optimiseddesign/optimised_kicad-libraries/README.md

# optimised_kicad-libraries
Created by Kevin Bibby / Optimised Product Design Ltd, and available for public use (copyright reserved).
KiCAD v10 component library with common symbols, footprints, 3d models, datasheets and other content for our PCB designs.
Note: some parts are customised for our businesses use case, and there may be undiscovered issues, so use is at your own risk.
Intended to be placed as a sub-folder (local libaries) within a KiCAD design folder, using the Git submodule feature.
