optimiseddesign/optimised_kicad-libraries/models3d/Bluegiga WT12.stp

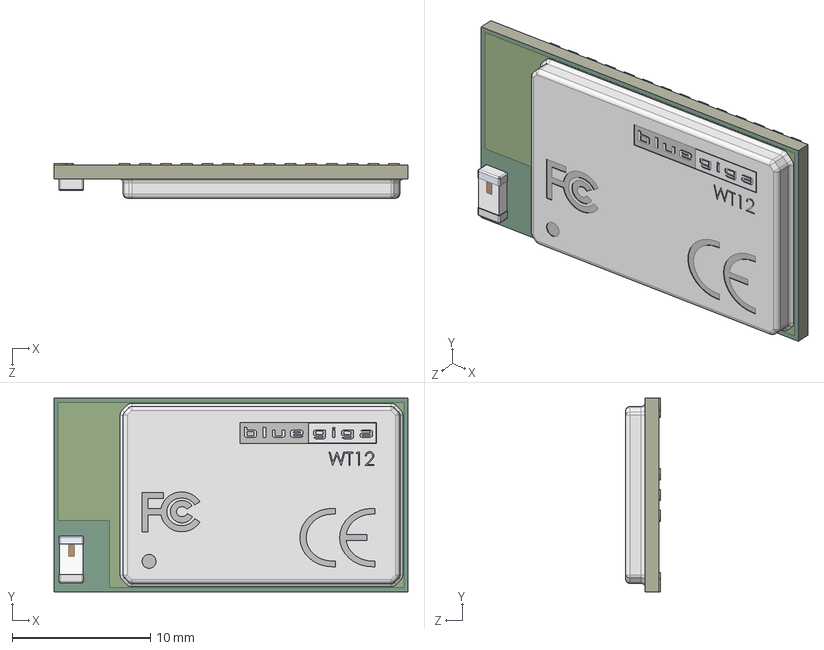
[picture p1: CAD file, 2019-12-03]
models3d/Bluegiga WT12.stp
25.6 x 14.0 x 2.50 mm
