optimiseddesign/optimised_kicad-libraries/documentation/new user setup.txt

Very rough intial notes to form basis for proper new user setup document/scripts.
Compiled from steps used 13/03/2020 when I got my replacement laptop.
-------------------------------------------------------------------------

Git 'Clone' the official library repos to C:\freelance\git\;
https://github.com/KiCad/kicad-symbols.git
https://github.com/KiCad/kicad-footprints.git
https://github.com/KiCad/kicad-packages3D.git
https://github.com/KiCad/kicad-templates.git

Git 'Reset' each one of these repos to the Tag which corresponds to the version of KiCAD installed (e.g. 5.1.4).

Install KiCAD.

Edit the following Windows environment variables (do this instead of KiCAD Preferences > Configure Paths, so they're persistent);
KICAD_SYMBOL_DIR		C:\freelance\git\kicad-symbols
KISYSMOD				C:\freelance\git\kicad-footprints
KISYS3DMOD				C:\freelance\git\kicad-packages3D
KICAD_TEMPLATE_DIR		C:\freelance\git\kicad-templates

Open KiCAD, and configure;
Preferences > Manage Symbol Libraries, then select global symbol table folder C:\freelance\git\kicad-symbols\sym-lib-table
Preferences > Manage Footprint Libraries, then select global footprint table folder C:\freelance\git\kicad-footprints\fp-lib-table

Added rough things after KiCAD v6, 2022-01-18;
-------------------------------------------------------------------------
Need to update all of above instructions for KiCAD v6, but most similar or fixed in my library

Install InteractiveHtmlBom v2.4.1 (or later with caution?) using plugin manager...
...copy config.ini from Git Repo optimised_kicad-libraries \environment\config.ini
...to C:\Users\<UserName>\Documents\KiCad\6.0\3rdparty\plugins\org_openscopeproject_InteractiveHtmlBom\ or similar

Clone KiBOM repo (Optimised fork) from https://github.com/optimiseddesign/KiBoM
In KiCAD Schematic Editor, Tools -> Generate BOM
Add a BOM generator with the Nickname and Commandline as below:
OptimisedPD_KiBOM_CSV
python "C:\freelance\git\KiBoM/KiBOM_CLI.py" -v "%I" "%O" -d "..\manufacturing"
plus, when outputting a BOM, temporarily copy \environment\bom.ini to the local KiCAD PCB folder
