optimiseddesign/optimised_kicad-libraries/(commit log)

2019-11-22 added gitattributes to convert line endings to LF for library files added blank schematic libraries
2019-11-22 added 3 footprint libraries to start off with renamed a couple of datasheet directories to match names for symbols
2019-11-22 added 3 models3d libaries to start off with to match footprint ones
2019-11-22 added fp-lib-table and sym-lib-table for symbols/footprints libraries so far
2019-11-22 added component led_smd_rgb_wurth_150141M173100 including footprint & step model & datasheet mainly to test out, still need to resolve many many things
2019-11-25 modified led_smd_rgb_wurth_150141M173100 - added part info & fields modified Wurth 150141M173100 footprint - regenerated from PCB Expert 2019-07 and datasheet... ...NOTE: polarity mark is on Pin3 as 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
2019-11-25 added spaces to unused fields in led_smd_rgb_wurth_150141M173100 so they don't get ignored... ...and made text sizes consistent added template symbols for CONNECTORS and DIODE-RECTIFIERS libraries
2019-11-25 renamed diodes-rectifiers library
2019-11-25 added Lumberg 1502 01 as 'audio_jack_3mm5_3contact_vertical_lumberg_1502-01'... ...including STEP model, datasheet etc, missing footprint for now & tweaks to symbol
2019-11-26 changed symbol and pins to match datasheet for audio_jack_3mm5_3contact_vertical_lumberg_1502-01 added STEP model for usb jack, Molex 105133-0001 added footprint for audio_jack_3mm5_3contact_vertical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
2019-11-26 added Molex 92315-1225 STEP model temporarily for cable assembly to use on PT106b
2019-12-02 added source files for Keystone #54 battery holder for 18650 (temp before library part fully made)
    [keystone-PN54.stp]
2019-12-02 added first rough version of a KiCAD pcbnew script... ...delete GND nets but unfortunately also deletes connected vias, to solve in future
2019-12-03 added miscellaneous footprint library to library path renamed Keystone 54 datasheet renamed & moved Keystone 54 step model added simple keystone 54 footprint (to be checked over etc) added generic 18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
2019-12-03 fix for delete_gnd_nets KiCAD pcbnew script which was causing it not to load added 3D STEP model for Bluegiga WT12 module, not yet organised/setup properly
    [Bluegiga WT12.stp]
2019-12-05 added assembly and silkscreen pin1 polarity marks added footprint description field moved silkscreen REF outside of component outline and added assembly/fab layer REF
2019-12-05 added symbol TEMPLATE_miscellaneous added batteryholder_18650_keystone-54 based on Battery_Cell official KiCAD symbol... ...tailored to match existing footprint for 18650 keystone 54 based part ...ad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
2019-12-10 removed central cross on F.CrtYd layer which PCB Expert creator adds but which causes KiCAD DRCs
2019-12-10 corrected pin numbering error on audio_jack_3mm5_3contact_vertical_lumberg_1502-01 after testing sample part
2019-12-20 adding KiCAD Titleblock file to test (just has test text added)
2019-12-20 renamed to say for Schematic
2019-12-20 copied the schematic titleblock for use as PCB Titleblock edited PCBLayout Titleblock test text to be distinct for PCB
2019-12-21 added PCB ID (uses Comment C0), copyright date, KB Consulting, etc to titelblock design removed test text from titleblock changed back to just one titleblock after testing, could do separate but don'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
2019-12-27 added Texas Instruments DRV2605L VSSOP-10 version to KBconsulting KiCAD library... ...incuding datasheet, part numbers etc, and new symbol ...uses footprint from official KiCAD library changed TEMPLA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
2019-12-30 adding templates for all library component types, setting RefDes, paths, pin names/numbers etc
2019-12-30 added ST Microelectronics LD39200PUR 2A DFN-6 Adjustable LDO regulator... ...added datasheet, uses existing official KiCAD footprint
2020-01-03 added first rough text for use in KiCAD design checklist document
2020-01-05 added bom.ini for KiBOM generation, default but customised for my fields etc make sure to temp change getDescription(self) in KiBOM component.py... ...if parts use "Description" field name (or change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
2020-01-05 added some more info to do with BOM generation
2020-01-24 changes to checklist to describe BOM output process better, using customised KiBOM
2020-03-13 added first rough notes for new user setup of kicad libraries
2020-03-13 lengthened batteryholder_18650_keystone_54 by 1.0mm after testing on VRGOmini main PCB PT106A 2.0 2A... ...some large protected 18650 cells are 70.5mm long (most 67-70mm) ...was 65.5mm between spring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
2020-03-15 added 'batteryholder_18650_keystone_54' hatched keepout indication on Dwgs.User layer & Cmts.User description
2020-04-13 added basic generic SMD resistors and capacitors 0402, 0603, 0805, 1206... ...uses symbols (R_small & C_small) and footprints from official KiCAD library ...1% for resistors, power rating ascending a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
2020-04-13 added basic generic 2.54mm header TH 01x04 way vertical... ...footprint & symbol (Connector_Generic / Conn_01x04) from official KiCAD libraries ...symbol pins modified to be shorter (2.54mm instead o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
2020-04-14 added security_microchip_atecc608a_i2c_soic-8... ...symbol copied from official KiCAD library (Security / ATECC608A-SSHDA) ...adjusted to add Pins 1,2,3,7 as NC invisible pins, and spaced pin text mo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
2020-04-14 added rtc_i2c_nxp_pcf8523_soic-8... ...symbol copied from official KiCAD library (Timer_RTC / PCF8523T) ...adjusted pin locations slightly ...footprint from official KiCAD library ...datasheet from n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
2020-04-14 added Crystal_32kHz_SMD_IQD_CFPX-217_20ppm_7pF... ...for IQD CFPX-217 with 20ppm tolerance, 7pF load (aka LFXTAL009709 order code) ...symbol copied from official KiCAD library (Device / Crystal_Small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
2020-04-14 renamed recent new components for new naming convention; not all lower-case added description in library parts where missing to help finding parts moved 'I2C' part of name to earlier in string for RT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
2020-04-14 added Cell-Holder_CR1220_Horizontal_SMD_Harwin_S8411-45R... ...symbol copied from official KiCAD library (Device / Battery_Cell) ...footprint created from scratch based on datasheet ...STEP model & d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
2020-04-15 added M12_Female_5pin_Right-Angle_TE-Connectivity_T4145015051-001... ...symbol copied (& heavily modified) from official KiCAD library (Connector / XLR5) ...footprint created from scratch based on da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
2020-04-15 corrected some part numbers put in the wrong fields added BT refdes for battery (cell) holder which just had 'REF?'
2020-04-16 added SODIMM-200_Socket_0.6mm_DDR2_Horizontal_SMD_TE-Connectivity_1473005-4... ...symbol & footprint modified from SnapEDA one (linked from TE website) ...symbol was only 100pins?! added remaining on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
2020-04-16 added USB2-A_Single_Horizontal_TH_Amphenol-ICC_UE27AC54100... ...symbol copied from official KiCAD (Connector / USB_A) ...symbol mirrored in vertical, pins & outline adjusted, D+/D- bidirectional pin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
2020-04-16 added USB2-B_Single_Horizontal_TH_TE-Connectivity_292304-1... ...symbol copied from official KiCAD (Connector / USB_B) ...symbol pins & outline adjusted, D+/D- bidirectional pins ...footprint copied 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
2020-04-16 added HDMI-A_Receptacle_Horizontal_SMD-TH_Amphenol-ICC_10029449-111RLF... ...symbol copied from official KiCAD (Connector / HDMI_A) ...symbol minor pin spacing adjustments ...footprint custom made fr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
2020-04-17 changed F.Fab text from "REF**" to "%R" (though still shows as REF**)... ...to fix several footprints created to make sure RefDes shows up on PCB Fab layer also fixed USB connectors shields to be 'SH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
2020-04-17 added RJ45-Mag_100Base-TX_Horizontal_TabDown_TH_Pulse-Electronics_J00-0045NL... ...symbol & footprint adapted from official KiCAD (Connector / RJ45_Amphenol_RJMG1BD3B8K1ANR) ...symbol modified pin po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
2020-04-17 added USB2_Switch_2Port_ON-Semi_FSUSB42_MSOP-10... ...symbol custom made ...footprint with 3D model used in official KiCAD (Package_SO / MSOP-10_3x3mm_P0.5mm) ...datasheet from On Semi website
2020-04-18 added Relay_SPDT_1A_5V_TH_OMRON_G5V-1... ...symbol copied from official KiCAD (Relay / G5V-1) ...symbol deleted '+' (datasheet says no coil polarity) ...symbol made pin6 visible and separate on symbo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
2020-04-18 added USB2_Hub-Quad_Eth-10-100_Microchip_LAN9514i... ...symbol (two parts) copied from official KiCAD (Interface_Ethernet / LAN9514i) ...symbol Eth pins birectional for AutoMDIX options and renamed e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
2020-04-19 renamed leds.pretty footprint library to diodes-rectifiers.pretty
2020-04-19 added both LED_SMD_2012_Red_2.1V_10mcd_Broadcom_HSMS-C170... ...and LED_SMD_2012_Green_2.2V_15mcd_Broadcom_HSMG-C170... ...symbol copied from official KiCAD (Device / LED_Small_ALT) ...symbol rotated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
2020-04-19 added Ferrite_SMD_1608_2A_120R_Murata_BLM18PG121SN1D... ...symbol copied from official KiCAD (Device / Ferrite_Bead_Small) ...footprint used official KiCAD (Inductor_SMD / L_0603_1608Metric) ...datas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
2020-04-19 added Oscillator_25MHz_SMD-4_3225_25ppm_85C_ECS-Inc_ECS-3225MV... ...symbol & footprint made custom ...footprint pads 1.1/1.4mm between datasheet 1.2/1.4mm & PCB Expert 1.0/1.25mm ...footprint pad sp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
2020-04-19 Modified Crystal_32kHz_SMD-2_3215_20ppm_7pF_IQD_CFPX-217... ...renamed to include case size, and rearranged to match oscillator ...added mouser part for Vendor2 ...footprint increased pads to match d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
2020-04-19 added EEPROM_4Kbit_Microwire_SOIC-8_ST-Micro_M93C66-W... ...symbol copied & modified from official KiCAD libraries (Memory_EEPROM / 93CxxC) ...symbol adjusted pin positions and box, added pin7 NC bac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
2020-04-20 added Switch_Slide_SPDT_Vertical_TH_CandK_L102011MS02Q... ...symbol copied from official KiCAD libraries (Switch / SW_SPDT) ...footprint custom made, pin numbering mirrored to follow regular TH numbe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
2020-04-20 added TerminalBlock_Screw_5.08mm_TH_01x03_Vertical_CamdenBoss_CTBP0708... ...symbol copied from official KiCAD libraries (Connector / Screw_Terminal_01x03) ...footprint from https://componentsearchen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
2020-04-20 small fix for Switch_Slide_SPDT_Vertical_TH_CandK_L102011MS02Q... ...corrected centreing STEP model after last minute change missed this
2020-04-20 added NMOS_Single_20V_0.9A_SOT-416_ON-Semi_NTA4153NT1G... ...symbol copied from official KiCAD libraries (Device / Q_NMOS_GSD) ...symbol gate/drain/source pin numbers match datasheet ...footprint cop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
2020-04-21 added footprints PCB_Silk_ID and PCB_Silk_Logo_KB first versions
2020-04-21 changes to USB2_Switch_2Port_ON-Semi_FSUSB42_MSOP-10... ...made less confusing, only one logical switch shown for both USB signals ...now HSD1+/- are together and HSD2+/- are together on the symbol
2020-04-21 swapped D+/D- on USB connector symbols, makes more sense to have D+ at the top
2020-04-21 added Header_2.54mm_TH_01x06_Vertical... ...copied from 01x04 and modified, i.e. ... ...footprint & symbol (Connector_Generic / Conn_01x06) from official KiCAD libraries ...symbol pins modified to be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
2020-04-22 added NMOS_Dual_60_8A_PowerPAK-SO-8_Vishay_Si7972DP... ...symbol copied from official KiCAD libraries (Device / Q_DUAL_NMOS_G1S2G2D2S1D1) ...symbol made pins match datasheet (added drain 7 & 8), adju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
2020-04-22 added TVS_Bidir_30V_400W_SMA_Diodes-Inc_SMAJ30CA... ...symbol copied from official KiCAD libraries (Device / D_TVS_ALT) ...symbol made smaller & vertical to match resistors/capacitors ...footprint co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
2020-04-22 added Protection_Input_Controller_AnalogDevices_LTC4365I_TSOT-23-8... ...symbol copied from official KiCAD libraries (Power_Management / LTC4365xTS8) ...symbol adjusted pin positions ...footprint use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
2020-04-22 changed TVS SMAJ library part to be generic for whole series... ...old name TVS_Bidir_30V_400W_SMA_Diodes-Inc_SMAJ30CA ...new name TVS_Bidir_400W_SMA_Diodes-Inc_SMAJ--CA ...30V voltage in part replac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
2020-04-23 added Al-Elec_Polarised_Radial_TH_35V_1000uF_D12.5xP5.0xH20.0mm_Rubycon_YXJ... ...symbol copied from official KiCAD libraries (Device / CP1_small) ...footprint copied from official KiCAD (Capacitor_T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
2020-04-23 added Al-Elec_Polarised_Radial_TH_10V_220uF_D5.0xP2.0xH11.0mm_Rubycon_YXJ... ...copied Al-Elec_Polarised_Radial_TH_35V_1000uF_D12.5xP5.0xH20.0mm_Rubycon_YXJ ...footprint copied mine (capacitors / Pol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
2020-04-23 added TestPoint_Pad_0.9mm... ...symbol copied from official KiCAD libraries (Connector / TestPoint) ...footprint made custom, no silk outline as just too cluttered for test pad ...no STEP model (just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
2020-04-24 changed to C&K L102011ML04Q (was Vertical now Horizontal / Right Angle)... ...renamed to Switch_Slide_SPDT_Horizontal_TH_CandK_L102011ML04Q ...decided to just replace, as other one won't be proven an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
2020-04-24 changed TerminalBlock_Screw_5.08mm_TH_01x03_Vertical_CamdenBoss_CTBP0708... ...footprint holes now 1.5mm/2.5mm, were 1.3mm/2.2mm ...after clarification & eng drawing by support, pins are 0.8x1.0mm
2020-04-25 added HDMI_Protection_Texas-Instruments_TPD12S521_TSSOP-38... ...symbol copied from official KiCAD libraries (Interface_HDMI / TPD12S520DBT) ...symbol changed pin 38 from No Connect to 5V_OUT ...symb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
2020-04-25 added LDO_Fixed_1V8_300mA_Diodes-Inc_AP2127K_SOT-23-5... ...symbol copied official KiCAD libraries (Regulator_Linear / AP2204K-1.8) ...footprint uses official KiCAD (Package_TO_SOT_SMD / SOT-23-5)
2020-04-25 added Protection_Output_HighSideSwitch_Dual_500mA_2V7-5V5_Microchip_MIC2026-1_SOIC-8... ...symbol copied official KiCAD libraries (Power_Management / MIC2026-1BM) ...renamed pins nFLGA and nFLGB for 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
2020-04-25 added TVS_Bidir_Dual_HighSpeedData_ST-Micro_USBLC6-2_SOT-666... ...symbol copied official KiCAD libraries (Power_Protection / USBLC6-2SC6) ...symbol rotated 90deg, and reduced height, sensible for pa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
2020-04-26 added NOR-2_Quad_1V65-3V6_Texas-Instruments_SN74LVC02A_TSSOP-14... ...symbol copied official KiCAD libraries (74xx / 74LS02) ...symbol copied manually from .lib to preserve 5-unit demorgan symbols ..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
2020-04-26 added IO_Isolated_Dual_Digital-Input-Receiver_24V-60V_Texas-Instruments_ISO1212_SSOP-16... ...symbol copied official KiCAD libraries (Isolator / ISO1212) ...symbol added second isolation line for saf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
2020-04-26 added LED_SMD_3010-Horizontal_Green-Red-Bicolour_2.0V_35-45mcd_Lite-On_LTST-S326KGJRKT... ...symbol copied official KiCAD libraries (Device / LED_Dual_CCA) ...symbol added green/red text next to led 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
2020-04-27 added Diode_Single_75V_150mA_Diodes-Inc_1N4148WS_SOD-323... ...symbol copied official KiCAD libraries (Device / D_ALT) ...footprint uses official KiCAD (Diode_SMD / D_SOD-323) ...datasheet from Diode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
2020-04-27 added official Lite On LED STEP model... ...for LED_SMD_3010-Horizontal_Green-Red-Bicolour_2.0V_35-45mcd_Lite-On_LTST-S326KGJRKT ...deleted old Wurth one used as a similar representation
2020-04-27 added Inductor_SMD_5050_0.6-100uH_11A-0.75A_WireWound_SemiShielded_Bourns_SRN5040TA... ...symbol copied official KiCAD libraries (Device / L_small) ...footprint copied from official KiCAD (Inductor_S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
2020-04-27 added DC-DC_Buck_Controller_3V8-36V_3A_1400kHz_Texas-Instruments_LMR33630_HSOIC-8... ...symbol created custom ...footprint copied from official KiCAD (Package_SO / Texas_HSOP-8-1EP_3.9x4.9mm_P1.27mm)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
2020-04-28 added Protection_Output_HighSideSwitch_Single_4A_3V5-40V_Texas-Instruments_TPS1H100A_HTSSOP-14... ...symbol made custom based on datasheet, for 'A' version pinout ...footprint custom made, initially 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
2020-04-28 added Fuse-FuseHolder_62mA-10A_SMD_9750m_Littelfuse_154-Series... ...symbol copied from official kicad libraries (Device / Fuse_Small) ...symbol rotated 90deg to match resistors, capacitors etc ...fo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
2020-04-29 added Schottky_Single_100V_200mA_ON-Semi_NSR02100HT1G_SOD-323... ...symbol copied official KiCAD libraries (Device / D_Schottky_Small_ALT) ...footprint uses official KiCAD (Diode_SMD / D_SOD-323) ...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
2020-04-29 corrected footprint Fuse-FuseHolder_SMD_9750m_Littelfuse_154-Series... ...two of the courtyard lines were accidentally on Fab layer, fixed
2020-04-30 added TaiyoYuden_WYSEGVDXG (working name, work in progress... ...noddy unfinished first version of schematic symbol just for initial show & tell ...set footprint from KiCAD official libraries (RF_Wif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
2020-05-04 hidden silkscren 'Value' text in PCB_Silk_ID... ...haven't found a good way of making this & Silk ID work as footprints yet ...so for now just use as reference, but manually place in each PCB design
2020-05-06 added M12_Female_5pin_Vertical_TE-Connectivity_T4141012051-000... ...symbol copied from M12_Female_5pin_Right-Angle_TE-Connectivity_T4145015051-001 ...footprint copied from _kb_connectors:M12_Female_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
2020-05-06 corrected M12_Female_5pin_Right-Angle_TE-Connectivity_T4145015051-001... ...pin numbering corrected (pin3&5 were swapped due to datasheet diagram ambiguity) ...datasheet renamed to match fact it appl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
2020-05-07 added Header_2.54mm_TH_02x16_Horizontal_Wurth_61303221021... ...gone for specific part rather than ANY as mechanics matters for PT111A/PT111B fitment ...symbol copied from official KiCAD library (Con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
2020-05-08 added TerminalBlock_Screw_5.08mm_TH_01x02_Vertical_CamdenBoss_CTBP0708... ...symbol copied from 3way TerminalBlock_Screw_5.08mm_TH_01x03_Vertical_CamdenBoss_CTBP0708 ...footprint copied from Terminal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
2020-05-12 added Switch_Slide_SPDT_Horizontal_TH_CandK_L102121ML04Q... ...part & footprint copied from Switch_Slide_SPDT_Horizontal_TH_CandK_L102011ML04Q ...footprint modified actuator for scredriver-slot type,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
2020-05-12 added Socket_2.54mm_TH_02x16_Vertical_Samtec_SSW-116-01-L-D... ...went for 10u" gold as PT111B mating header is gold plated and tin-gold would corrode ...symbol copied from Header_2.54mm_TH_02x16_Hor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
2020-05-15 modified LED_SMD-4_3528_Wurth_150141M173100... ...renamed, was led_smd_rgb_wurth_150141M173100 ...to fit in with new naming style ...updated footprint reference to fix library name change and now par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
2020-05-16 moved silkscreen polarity marks inside courtyard for all library footprints... ...better due to kicad limitation of not being able to move footprint silk in PCB some other minor adjustments/ correcti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
2020-05-17 added TerminalBlock_Pluggable_5.08mm_TH_01x03_Horizontal_TE-Connectivity_796638-3... ...copied from TerminalBlock_Screw_5.08mm_TH_01x03_Vertical_CamdenBoss_CTBP0708 ...symbol modified to look like pl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
2020-05-17 added TerminalBlock_Pluggable_5.08mm_TH_01x02_Horizontal_TE-Connectivity_796638-2... ...copied from TerminalBlock_Pluggable_5.08mm_TH_01x03_Horizontal_TE-Connectivity_796638-3 ...symbol & footprint m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
2020-05-18 added Inductor_SMD_1005 , Inductor_SMD_1608, Inductor_SMD_2012... ...generic part for any inductor series, to be filled in ...footprint uses official KiCAD library (Inductor_SMD / L_0402_1005Metric) 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
2020-05-18 added Coaxial-U.Fl_SMD_Vertical_Hirose_U.FL-R-SMT-1... ...symbol copied from official KiCAD (Device / Antenna_Shield) ...footprint uses official KiCAD (Connector_Coaxial / U.FL_Hirose_U.FL-R-SMT-1_Ve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
2020-05-19 modified WiFi-BT_SMD_ExtAntenna_TaiyoYuden_WYSEGVDXG... ...renamed from working name TaiyoYuden_WYSEGVDXG ...added all part attributes, set pin types correctly ...renamed 'NC' pins to 'RES' to match 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
2020-05-20 added Header_2.54mm_TH_01x05_Vertical... ...copied from 6way version Header_2.54mm_TH_01x06_Vertical ...changed part info, footprint etc
2020-05-20 added TestPoint_TH_Loop_1.27mm_Keystone_5001... ...symbol copied from TestPoint_Pad_0.9mm ...footprint copied from TestPoint_Pad_0.9mm, modified for 1.0mm hole etc for part ...STEP model and datashee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
2020-05-20 modified TestPoint_Pad_0.9mm - made F.Fab Value text hidden
2020-05-21 added Oscillator_26MHz_SMD-4_2520_10ppm_85C_ECS-Inc_ECS-2520S... ...copied from Oscillator_25MHz_SMD-4_3225_25ppm_85C_ECS-Inc_ECS-3225MV ...included square wave graphic to denote oscillator ...change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
2020-05-21 added Oscillator_16MHz_SMD-4_2520_10ppm_85C_ECS-Inc_ECS-2520S... ...copied from Oscillator_26MHz_SMD-4_2520_10ppm_85C_ECS-Inc_ECS-2520S ...same footprint, STEP, datasheet ...just changed part numbers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
2020-05-22 added USB3.1-C_Single_Horizontal_SMD_Receptacle_Amphenol_12401610E4-2A... ...symbol copied from official KiCAD (Connector / USB_C_Receptacle) ...symbol customised (all pins visible, VBUS output) ...f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
2020-05-22 added Balun_868-915MHz_SMD-6_2012_Johanson_0896BM15A0001... ...symbol custom made, similar to existing PT117A one ...refdes Z chosen for Balun/matched network ...footprint custom made based on datash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
2020-05-23 added Schottky_Dual_60V_1A_SOT223_Nexperia_BAT160C... ...symbol copied from official KiCAD (Device / D_Schottky_x2_KCom_AKA) ...symbol changed Pin4 common cathode, added Pin2 NC (not visible) ...foot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
2020-05-23 made bottom ground pads pin51-56 solid connection
2020-05-26 added TerminalBlock_Screw_3.81mm_TH_01x02_Horizontal_TE-Connectivity_284392... ...copied from TerminalBlock_Screw_5.08mm_TH_01x02_Vertical_CamdenBoss_CTBP0708 ...footprint from snapeda.com then custo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
2020-05-26 made centre ground pad solid/full contact
2020-05-28 fixed STEP models to be native size with 1:1 scale... ...was using scale in KiCAD to adjust official library models ...this caused issue as exported STEP from KiCAD ignores this scale! ...generated e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
2020-05-28 added NMOS_Dual_100V_8A_PowerPAK-SO-8_Vishay_Si7252DP... ...copied from NMOS_Dual_60V_8A_PowerPAK-SO-8_Vishay_Si7972DP ...footprint uses same library part ...datasheet from Vishay website corrected n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
2020-05-28 added Flash_NOR_32MBit_SPI_SOIC-8_Adesto_AT25SF321B... ...symbol created custom to match datasheet pins ...footprint from official KiCAD (Package_SO / SOIC-8_3.9x4.9mm_P1.27mm) ...datasheet from Ades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
2020-05-29 modified LDO_Adjustable_2A_STMicro_LD39200_DFN-6 ...renamed from ldo_adj_2A_STMicro_LD39200_DFN-6 to match others ...added 2nd supplier part number, expanded descriptiont text added LDO_Fixed_3V3_2A_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
2020-05-29 added DCDC_Buck-Boost_Converter_Fixed_5V_2A_2V5-12V_2400kHz_Texas-Instruments_TPS63061_WSON-10... ...symbol copied from: DC-DC_Buck_Controller_3V8-36V_3A_1400kHz_Texas-Instruments_LMR33630_HSOIC-8 ..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
2020-05-29 added Inductor_SMD_2520_0.24-2.2uH_2.3A-4.7A_WireWound_SemiShielded_Bourns_SRN2512... ...copied from Inductor_SMD_5050_0.6-100uH_11A-0.75A_WireWound_SemiShielded_Bourns_SRN5040TA ...symbol left the s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
2020-05-29 added DCDC_Buck_Converter_6V-100V_0.5A_1000kHz_Texas-Instruments_LM5163_HSOIC-8 ...footprint new, but 2.4mm EP not 2.6mm, copied from previous; SOIC-8-1EP_W3.9xL4.9xH1.7mm_P1.27mm_EP2.6x3.1mm_TexasIn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
2020-05-31 added Al-Elec_Polarised_Radial_TH_50V_22uF_D5.0xP2.0xH11.0mm_Rubycon_YXJ... ...same datasheet / footprint as existing part: Al-Elec_Polarised_Radial_TH_10V_220uF_D5.0xP2.0xH11.0mm_Rubycon_YXJ ...part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
2020-05-31 added Schottky_Dual-AKAK_30V_0.2A_SOT23_ON-Semi_BAT54SL... ...symbol copied from official KiCAD (Device / D_Schottky_x2_Serial_AKC) ...footprint uses official KiCAD libraries (Package_TO_SOT_SMD / SO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
2020-05-31 added Header_2.54mm_TH_02x04_Vertical... ...symbol copied from official KiCAD (Connector_Generic / Conn_02x04_Odd_Even) ...footprint used official KiCAD (Connector_PinHeader_2.54mm / PinHeader_2x04_P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
2020-05-31 added Header_2.54mm_TH_01x08_Vertical... ...copied & modified incl symbol from existing Header_2.54mm_TH_01x06_Vertical ...footprint uses official KiCAD (Connector_PinHeader_2.54mm / PinHeader_1x08_P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
2020-05-31 added TagConnect_6pin_NoLegs... ...symbol custom made ...symbol pinout signals to match Tag-Connector JLINK adapter ARM20-CTX ...footprint custom made based on datasheet layout recommendation ...foot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
2020-05-31 added Header_2.54mm_TH_01x09_Vertical... ...copied from Header_2.54mm_TH_01x08_Vertical ...edited part info and changed footprint to suit ...footprint uses official KiCAD (Connector_PinHeader_2.54mm 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
2020-06-01 added Header_2.54mm_TH_01x02_Vertical... ...copied from Header_2.54mm_TH_01x03_Vertical ...changed symbol & part attributes for 2way ...uses footprint in official KiCAD (Connector_PinHeader_2.54mm / 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
2020-06-02 added TerminalBlock_Screw_3.81mm_TH_01x03_Horizontal_TE-Connectivity_284392... ...copied from 2way version TerminalBlock_Screw_3.81mm_TH_01x02_Horizontal_TE-Connectivity_284392 ...symbol modified for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
2020-06-02 added Socket_2.54mm_TH_01x03_Vertical... ...copied from Header_2.54mm_TH_01x03_Vertical ...symbol kept the same, updated part info ...footprint used official KiCAD (Connector_PinSocket_2.54mm / PinSo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
2020-06-02 corrected TerminalBlock_Screw_3.81mm_TH_01x03_Horizontal_TE-Connectivity_284392 ...had error with 3way terminal block footprint ...had duplicate pin2, changed one to pin3
2020-06-02 added Fuse_0.75A-8A_SMD_3216_Belfuse_C1T... ...schematic part copied from Fuse-FuseHolder_62mA-10A_SMD_9750m_Littelfuse_154-Series ...changed refdes to F, modified part attributes for Bel Fuse C1T se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
2020-06-04 added TVS_Bidir_400W_SOD-123FL_Littelfuse_SMF4L--CA... ...symbol copied from TVS_Bidir_400W_SMA_Diodes-Inc_SMAJ--CA ...footprint copied from official KiCAD (Diode_SMD / D_SOD-123F) ...footprint chang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
2020-06-04 added Schottky_Single_60V_2A_Nexperia_PMEG6020ER_SOD-323W... ...copied from Schottky_Single_100V_200mA_ON-Semi_NSR02100HT1G_SOD-323 ...footprint copied from my library (SOD-123FL_Bidir) ...footprint 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
2020-06-04 created 'Logo' - schematic part only... ...generic for all, to assign footprint after placing in design created singing cat logo footprints using kicad bitmap converter... ...added small Singing Cat 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
2020-06-05 added PCB_Antenna_2400MHz_W5.5xL15.1mm_MIFA_ESP-WROOM-02_Left... ...symbol made custom based on template ...footprint from https://github.com/prasad-dot-ws/ESP32_MIFA_PCB_ANTENNA ...easier, someone a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
2020-06-05 corrected footprint PCB_Antenna_2400MHz_W5.5xL15.1mm_MIFA_ESP-WROOM-02_Left... ...made distance to GND plane match gerbers, missed this before ...adjusted dimensions pdf to match ...also removed odd 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
2020-06-05 added PCB_Antenna_868-920MHz_W12.3xL19.5mm_Helical_Texas-Instruments_DN038_Right... ...copied from PCB_Antenna_2400MHz_W5.5xL15.1mm_MIFA_ESP-WROOM-02_Left ...symbol and attributes adjusted for this a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
2020-06-05 modified PCB_Antenna_868-920MHz_W12.3xL19.5mm_Helical_Texas-Instruments_DN038_Right ...corrected, removed pin2 GND (not present in footprint) ...GND reference plane assumed on PCB up to keepout line
2020-06-06 added Header_2.54mm_TH_01x10_Vertical... ...copied from Header_2.54mm_TH_01x09_Vertical ...edited part info and changed footprint to suit ...footprint uses official KiCAD (Connector_PinHeader_2.54mm 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
2020-06-10 few quality-of-life improvements on the whole library of footprints... ...made sure F.Fab text does not have 'visible' ticked so they don't appear in fab drawing ...made sure Silk refdes does not hav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
2020-06-10 corrected typo in MLCC Capacitor parts 'As Approriate' changed to 'As Appropriate'
2020-06-18 changed field export order so FitPart is close to start for better BOM arrangement
2020-06-18 corrected MPN1 for two ECS-2520S33 parts... ...dashes were strange ASCII codes which cause weird BOM formatting
2020-06-18 added 'N/A' MPN and description to 'Logo' part copied part attribute 'description' into library description too for TestPoint_Pad_0.9mm
2020-07-03 added LDO_Fixed_1V8_300mA_Texas-Instruments_TLV702_SOT-23-5... ...copied from LDO_Fixed_1V8_300mA_Diodes-Inc_AP2127K_SOT-23-5 ...TI TLV70218DBV which has better performance with large capacitances ..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
2020-07-08 corrected SMD type for part Oscillator_SMD-4_3225_ECS-Inc_ECS-3225MV... ...was incorrectly through-hole type
2020-07-27 added Crystal_32MHz_SMD-4_2016_10ppm_10ppm_10pF_ECS_ECX-1637B... ...symbol copied from Crystal_32kHz_SMD-2_3215_20ppm_7pF_IQD_CFPX-217 ...symbol modified pins to match datasheet, add 2 GND pins ...fo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
2020-07-28 added BT-SoC_SMD_Nordic_nRF52833_QFN-40... ...symbol copied from official KiCAD (MCU_Nordic / nRF52832-QFxx) ...symbol pins and arrangement modified substantially to match nRF52833 and preferences ..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
2020-07-30 added LDO_Fixed_5V0_50mA_ON-Semi_NCP715_XDFN-6... ...symbol copied from LDO_Fixed_1V8_300mA_Texas-Instruments_TLV702_SOT-23-5 ...symbol pins and arrangement modified to match NCP715 ...footprint made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
2020-08-12 added Antenna_Chip_2400MHz_SMD-4_1608_TDK_ANT016008LCS2442MA2_Left... ...symbol copied from official KiCad (Device / Antenna_Chip) ...footprint custom created based on datasheet recommended ...footpr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
2020-08-17 added TerminalBlock_Pluggable_3.50mm_TH_01x03_Horizontal_Wurth_691322110003... ...copied from TerminalBlock_Pluggable_5.08mm_TH_01x03_Horizontal_TE-Connectivity_796638-3 ...adjusted fields etc for ne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
2020-08-17 added TerminalBlock_Pluggable_3.50mm_TH_01x02_Horizontal_Wurth_691322110002... ...copied from TerminalBlock_Pluggable_3.50mm_TH_01x03_Horizontal_Wurth_691322110003 ...adjusted symbol, fields etc for 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
2020-08-18 added Inductor_SMD_4532_1.0-2200uH_1.3A-30mA_WireWound_UnShielded_Murata_LQH43NH... ...made for whole LQH43NH series, to customise part info when placed ...symbol copied from Inductor_SMD_5050_0.6-10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
2020-08-19 added Socket_2.54mm_TH_01x03_Vertical_Everconn_D161... ...holes to accept Everconn D161 crimped wires (this part is DNF, just holes) ...symbol copied from Socket_2.54mm_TH_01x03_Vertical and adjusted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
2020-08-20 changed Socket_2.54mm_TH_01x03_Vertical_Everconn_D161... ...increased pitch from 2.54mm to 2.84mm, was nervous about clearance ...increased gap between pins by 0.3mm, will still fit a 2.54mm header f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
2020-08-20 added Opamp_Single_1.2MHz_3.5V-16V_SMD_Microchip_MCP6H01_SC-70-5... ...created from template, symbol copied from official KiCAD (Amplifier_Operational / MCP6L91RT-EMS) ...symbol adjusted pin numbers 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
2020-08-21 added new smaller fp versions of 0402(1005m) chip SMD resistors & capacitors, IPC 'Nominal' & 'Least'... ...footprints created in PCB Library Export Pro 2019.07, for +/-0.05mm tolerances and 0.25mm e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
2020-08-24 corrected error in Antenna_Chip_2400MHz_SMD-4_1608_TDK_ANT016008LCS2442MA2_Left... ...moved pin2 & pin3 (NC pins) so they aren't on top of each other, which caused a netlist join
2020-08-30 added library parts 'Capacitor_SMD_0201_0603m' and 'Resistor_SMD_0201_0603m' with new footprints... ...new IPC Nominal as default, can select IPC Least manually per-design if needed added new smaller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
2020-09-05 added library part 'Inductor_SMD_0201_0603m' with new footprints both Nominal & Least... ...copied from existing 'Capacitor_SMD_0201_0603m' for both part and footprints ...new IPC Nominal as default,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
2020-10-16 added WiFi-BT_SMD_Espressif_ESP32-PICO-V3_LGA-48... ...created from template, copied symbol from official KiCAD (RF_Module / ESP32-PICO-D4) ...adjusted pins and symbol for the PICO-V3 as well as my p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
2020-10-21 added Switch_RF_SPDT_6GHz_SMD_Infineon_BGS12SN6_TSNP-6-2... ...for Infineon RF Switch for PT117A, decided relays-switches best fit with SW refdes (but footprint in semiconductors-smd) ...symbol copie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
2020-10-22 added Filter-Matched_868-915MHz_SMD-10_2012_Johanson_0900FM15D0039... ...for LoRa filter network part specific to Semtech SX1261 SX1262 LLCC68 ...symbol made custom based on datasheet pins ...datashe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
2020-10-22 added LoRa_SMD_Semtech_SX1262_QFN-24... ...symbol and pins custom made based on datasheet (except pin25 used for EP GND not 0, to match fp & convention) ...footprint from official KiCAD library (Pack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
2020-10-22 added LED_SMD_1608_Green_3.2V_430mcd_Wurth_150060GS75000... ...for Wurth LED, with new footprint incl. Least option ...symbol copied from LED_SMD_2012_Green_2.2V_15mcd_Broadcom_HSMG-C170 ...footprint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
2020-10-22 added Optimised Product Design branded Titleblock, incl web address and logo... ...kept previous KBconsulting one for now in case it caused issues opening designs ...added Author field, think importa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
2020-10-23 minor change to Switch_RF_SPDT_6GHz_SMD_Infineon_BGS12SN6_TSNP-6-2... ...moved symbol SW_RFI pin slightly to better line up in schematic with adjacent RF switch minor change to Filter-Matched_868-915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
2020-10-26 adjusted 'LoRa_SMD_Semtech_SX1262_QFN-24' symbol, moved power pins to make schematic drawing easier
2020-11-04 added 'TCXO_32MHz_SMD-4_2016_2.5ppm_85C_NDK_NT2016SA-END4263A'... ...based on NDK part NT2016SA-32M-END4263A as recommended by Semtech and in reference designs (possibly custom for Semtech/LoRa?) ...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
2020-11-04 added 'Ferrite_SMD_1005_1A_10R_Murata_BLM15PG100SN1D'... ...copied from Ferrite_SMD_1608_2A_120R_Murata_BLM18PG121SN1D and adapted as needed ...footprint uses KiCAD official library part (Inductor_SM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
2020-11-12 modified TSNP-6-2_Infineon footprint pads from 0.25mm to 0.24mm... ...to fix issue with exactly 0.15mm gap and 0.15mm DRC when part rotated
2020-11-20 added KiCAD hotkeys file from DevTank (converted to Excel)
    [KiCAD_Hotkeys.xlsx]
2021-01-09 added Socket_2.54mm_TH_01x12_Vertical... ...copied from Socket_2.54mm_TH_01x03_Vertical and modified symbol ...uses official KiCAD footprint (Connector_PinSocket_2.54mm:PinSocket_1x03_P2.54mm_Vertica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
2021-01-09 added Socket_2.54mm_TH_02x08_Vertical... ...copied from Socket_2.54mm_TH_01x12_Vertical ...symbol mirrored pins in Y axis so pin1 top-right to match footprint ...this is because socket 2way footprint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
2021-01-22 added PCB_NFC-Coil_13.56MHz_WxLmm_PT118C... ...work in progress NFC coil footprint for PT118C (attaches to PT118A) ...based on ST eDesign NFC Antenna calculator for 15x15mm square ...gives 930nH with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
2021-01-26 renamed symbol & footprint with dimensions in it finished symbol & attributes off (self-contained, pads built into footprint) adjusted bottom copper pads, for connection to PT118A 2.0 with sprung pin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
2021-01-26 made pads slightly larger, added soldermask gaps on pads!
2021-01-31 changed LOGO value field so it's visible, will be useful to describe logo on schematic added footprint PCB_Silk_Logo_fyt.kicad_mod for VRGO fyt logo... ...imported from DXF (0.1 scale) and then added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
2021-01-31 added silkscreen Optimised design logo... ...converted from original logo files to DXF, then imported and added inner polygons
2021-02-18 added Sensor_IMU_I2C-SPI_STMicroelectronics_LSM6DSL_LGA-14L... ...created from template, symbol made fresh to match datasheet ...added footprint LGA-14L_W3.0xL2.5xH0.86mm_P0.5mm_ST-Micro ...footprint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
2021-02-18 fixed silkscreen text width/height from 0.5mm (not printable) to 0.8mm
2021-02-21 added Button_Push_SPST_Vertical_SMD_TEConnectivity_FSM8JSMA... ...created from template, symbol modified from KiCAD official (Switch/SW_Push) ...added extra pins for 4pin device (1&2 joined, 3&4 join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
2021-02-24 added Header_2.00mm_SMD_01x02_Horizontal_JST_PH... ...part copied from template, symbol from Header_2.54mm_TH_01x02_Vertical ...footprint copied KiCAD JST_PH_S2B-PH-SM4-TB_1x02-1MP_P2.00mm_Horizontal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
2021-02-24 added BT_SMD_PCBAntenna_Fanstel_BM833... ...copied from BT-SoC_SMD_Nordic_nRF52833_QFN-40 ...pins modified for BM833 module, and its aQFN73 nRF52833 version ...footprint adapted from BM840 one linked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
2021-02-26 added LED_SMD-4_2220_RGB_Broadcom_ASMB-KTF0-0A306... ...created from template, symbol copied from official KICAD (Device:LED_ARGB) ...footprint created custom based on datasheet recommendations... ..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
2021-03-01 added NMOS_Single_20V_0.8A_DFN0606-3_Nexperia_PMH600UNE... ...copied from NMOS_Single_20V_0.9A_SOT-416_ON-Semi_NTA4153NT1G ...(TINY!) footprint based on datasheet recommendations... ...(almost exactl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
2021-03-02 added Header_1.27mm_TH_02x05_Vertical_Shrouded... ...commonly for SWD programming, shrouded for IDC 10way 1.27mm cable ...dual-source with Amphenol / Samtec part, keep part general ...copied from Hea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
2021-03-02 added BuzzerMag_70dBA_3Vop_4kHz_SMD_4040_CUI_CMT-4023S-SMT-TR... ...created from template, symbol copied from KiCAD (Device:Buzzer) ...footprint from CUI website, modified... ...Pin numbered 1/2 to m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
2021-03-02 corrected all my footprints with wrong F.Fab REF** text... ...even though displays as REF** must be entered as %R !!
2021-03-03 added Sensor_Cap_2Ch_GPIO_Microchip_MTCH102_UDFN-8... ...created from template, symbol custom to match datasheet ...footprint created with PCB Library Expert Pro 2020.02 ...created for IPC 'Least' du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
2021-03-04 added Charger_Lithium_Single_0A5_4V2_Microchip_MCP73831_DFN-8... ...from template, symbol from KiCAD (battery_management:MCP73832-2-OT) ...modified to match DFN pinout, my conventions etc ...footprin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
2021-03-05 added ASMB-KTF0-0A306 STEP version received from Broadcom adjusted footprint to align changed model
2021-03-10 added TestPoint_Pad_1.3mm... ...copied from TestPoint_Pad_0.9mm and changed values ...footprint similarly copied from TestPoint_Pad_0.9mm and modified
2021-03-18 added LDO_Fixed_5V0_300mA_ON-Semi_NCP718_WDFN-6... ...copied from LDO_Fixed_5V0_50mA_ON-Semi_NCP715_XDFN-6 ...changed for NCP718BMT500TBG (non-active-discharge WDFN-6 version) ...datasheet from ON Se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
2021-03-18 adjusted footprint slightly to suit both ON Semi NCP718 & TI TPS7A25... ...renamed to general footprint ...made pads 0.45mm long as both says ...made pads 0.35mm width as halfway in 0.40/0.30mm recom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
2021-03-22 added LDO_Fixed_3V3_300mA_Texas-Instruments_TPS7A25_WSON-6... ...copied from LDO_Fixed_5V0_300mA_ON-Semi_NCP718_WDFN-6 ...pinout, description, parts numbers etc adjusted for TPS7A25 fixed 3V3 ...foot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
2021-03-22 added Diode_Single_85V_215mA_Diodes-Inc_BAS116LPH4_DFN1006-2... ...used template; symbol from Diode_Single_75V_150mA_Diodes-Inc_1N4148WS_SOD-323 ...footprint created manually based on datasheet ...fo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
2021-03-29 added TerminalBlock_Push_2.00mm_SMD_01x01_Horizontal_AVX_70-9296... ...from template, symbol adapted from a header ...for AVX 709296001002006 (2mm width, more like 2.7mm min pitch) ...footprint custo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
2021-04-01 added Antenna_Helical_2400MHz_SMD-4_Molex_479480001... ...part copied from template, symbol from other antenna & adapted ...footprint custom based on datasheet ...footprint pads 10% rounded rect not 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
2021-04-08 added SuperCap_SMD_3V3_11mF_3225_Seiko_CPH3225A... ...part copied from template, symbol from Al-elec Polarised ...footprint custom based on datasheet recommendation ...3D STEP model from SnapEDA (non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
2021-04-08 added footprints for library parts 'Capacitor_SMD_0603_1608m' and 'Resistor_SMD_0603_1608m'... ...including IPC Least versions ...footprints created in PCB Library Export Pro 2020.02... ...for +/-0.1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
2021-04-08 added silkscreen/copper footprint for TELOS (GNUK) logo... ...based on their website PNG converted to DXF ...DXF imported as used as outline, with shapes inside ...same method as Optimised Logo ...bu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
2021-04-08 changed pads from 0.46mm to 0.45mm wide... ...slightly narrower to allow 0.1mm soldermask web between pads
2021-04-09 added SpringFinger_Preloaded_1.0x2.9mm_3.0mmH_SMD_TE-Connectivity_2108609-5... ...part copied from template, symbol custom made ...footprint custom based on datasheet drawing ...datasheet & 3D STEP m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
2021-04-12 footprint of TerminalBlock_Push_2.00mm_SMD_01x01_Horizontal_AVX_70-9296... ...added top copper keepout area in centre ...to avoid possibility of shorts to planes/other
2021-04-16 added MountingHole_Pad... ...copied from official KiCAD Mechanical:MountingHole_Pad ...added my part attributes/description etc ...generic part, description to be filled in & footprint selected added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
2021-04-21 added RTC_I2C_MicroCrystal_RV-3028-C7... ...from template, symbol copied and adapted from Timer_RTC:RV-1805-C3 ...footprint custom based on datasheet ...3D step model from Samacsys linked from offici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
2021-05-11 added PCB_NFC-Capsense_PT118C-2.0... ...copied from PCB_NFC-Coil_13.56MHz_W14.9xL17.6mm_PT118C ...**work in progress** for testing ...to use for PT118C 2.0 release ...for larger & new pcb outline, no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
2021-06-03 added Button_Push_SPST_Vertical_SMD_TEConnectivity_FSM6JSMA... ...copied from Button_Push_SPST_Vertical_SMD_TEConnectivity_FSM8JSMA ...for slightly shorter 7.01mm button on latest PT115A (other 9.50m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
2021-06-07 added PCB_Silk_Logo_TELOS_2... ...same as PCB_Silk_Logo_TELOS but full silkscreen ...(no soldermask 'O' for copper behind to show through)
2021-06-07 added TestPoint_Pad_1.1mm... ...to use for PT118C 2.0, simple 1.1mm pad ...copied and modified from TestPoint_Pad_1.3mm corrected description text in TestPoint_Pad_1.3mm footprint
2021-07-15 added LED_SMD-6_2827_RGB_OSRAM_KRTB-LFLP71.32... ...copied from LED_SMD-4_2220_RGB_Broadcom_ASMB-KTF0-0A306 and adapted ...footprint created custom based on datasheet ...datasheet and 3D STEP model f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
2021-07-27 added footprint MountingHole_M2.0_2.15mm_Pad3.8mm... ...for TR Fastenings TR00036498-103 ...0.15mm hole margin to tighten up instead of 0.2mm last pcb ...pad sized for 3.0mm head +0.2mm estimated max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
2021-07-27 added OR-2_Quad_2V0-6V0_Texas-Instruments_SN74HCS32_TSSOP-14... ...copied from NOR-2_Quad_1V65-3V6_Texas-Instruments_SN74LVC02A_TSSOP-14 ...updated description, pins etc as needed (different pinout) 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
2021-07-27 added Zener_Single_2V4-30V_500mW_Nexperia_TDZxJ_SOD-323F ...made part generic for whole series ...symbol copied from KiCAD official Device:D_Zener_Small_ALT ...symbol adjusted to 2off 45deg zener lin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
2021-07-28 added Relay_Socket_SPDT-DPDT_TH_OMRON_PT08-0... ...copied from Relay_SPDT_1A_5V_TH_OMRON_G5V-1 ...for PT08-0 Relay socket - for LY series 1 or 2 pole relays ...for use on PT127A with LY2-DC24 relay .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
2021-07-29 Added part 3-8_Demultiplexer_3V-5V5_Texas-Instruments_74AC11138PWR_TSSOP-16 Symbol added TSSOP16 footprint added (copied from kicad and slightly modified) 3D model added too
2021-07-30 Added new component SN74HCS238PWR 3:8 decoder Added part attributes Added datasheet Assigned preexisting footprint Made new symbol Also assigned TSSOP16 footprint to 74AC11138PWR, as it was missing.
2021-07-30 Changed pin 12 to 16, as there was as duplicate pin 12. (result of copy and paste error) Now fixed
2021-07-30 minor changes for my preferences... ...renamed to Header_4.20mm_TH_02x03_Horizontal_Molex_39300060 ...moved refdes/value next to part ...minor renames in attributes, datasheet etc ...given pins 1&2 t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
2021-07-30 added TerminalBlock_Screw_3.81mm_TH_01x06_Horizontal_TE-Connectivity_284392....6way of same 3way already in library, copied & modified ...footprint copied 3way same series and modified for 6way ...ST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
2021-08-02 changes for review & preferences... ...renamed Demux3-8_Schmitt_2V-6V_Texas-Instruments_SN74HCS238_TSSOP-16 ...set symbol pin names, changed to use pin names rather than text ...centred symbol, added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
2021-08-03 Added part DC-DC_Buck_Controller_4V-36V_1A_400kHz_Texas-Instruments_LMR23610_HSOIC-EP-8 ...added part attributes (datasheet, etc)... ...reused footprint from other simple switcher...
2021-08-03 Finished footprint for Bourns SRN8040... ...Added 3d model....
2021-08-03 Fixed symbol, it still had the Power Good pin, not available on this device
2021-08-03 Al-Elec_Polarised_Radial_TH_25V_100uF_D5.0xP2.0xH11.0mm_Rubycon_YXJ... ...review; ...corrected lifetime rating 5000hours for 25V rated 5mm case ...put Farnell / RS components as suppliers (UK take pr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
2021-08-04 Part amended Inductor_SMD_8282_0.5-100uH_12-1A_WireWound_SemiShielded_Bourns_SRN8040 ...Changed 8040 to 8282, from dimension of PCB footprint in datasheet... ...Updated the range to 0.1-100 as per da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
2021-08-04 Changed symbol DC-DC_Buck_Controller_4V-36V_1A_400kHz_Texas-Instruments_LMR23610_HSOIC-EP-8 ...Added EP pin, changed text "EN" to "EN/Sync"...
2021-08-06 review and minor changes for preferences... ...renamed DCDC_Buck_Converter_4V-36V_1A_400kHz_Texas-Instruments_LMR23610_HSOIC-EP-8 ...fix minor naming inconsistencies with old part copied from ...e.g.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
2021-08-06 review and minor changes... ...renamed Inductor_SMD_8279_0.5-100uH_12-1A_WireWound_SemiShielded_Bourns_SRN8040 ...made generic for SRN8040 series (values entered when placed) ...footprint centred (IP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
2021-08-06 added Capacitor_SMD_1210_3225m... ...copied from Capacitor_SMD_1206_3216m ...generic part ...uses KiCAD official footprint Capacitor_SMD:C_1210_3225Metric
2021-08-10 added Al-Elec_Polarised_Radial_TH_50V_1uF_D5.0xP2.0xH11.0mm_Rubycon_YXJ... ...copied Al-Elec_Polarised_Radial_TH_50V_22uF_D5.0xP2.0xH11.0mm_Rubycon_YXJ ...same series/datasheet/footprint just 1uF ver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
2021-08-10 added Al-Elec_Polarised_Radial_TH_50V_47uF_D6.3xP2.5xH11.0mm_Rubycon_YXJ ...footprint copied mine (Polarised_Radial_TH_D5.0xP2.0xH11.0xLD0.5mm) ...footprint fab / courtyard adjusted for 6.3x11mm cap 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
2021-08-10 added Protection_Output_HighSideSwitch_Single_0.13A-2.7A_3V0-5V5_Diodes-Inc_AP22652_DFN-6 ...AP22652 for PT127A (Active-low EN & DFN-6 compromise for stock) ...datasheet from Diodes Inc website ...fo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
2021-08-10 added LED_SMD_2012_Orange_2.2V_8mcd_Broadcom_HSMD-C170... ...copied from existing LED_SMD_2012_Red_2.1V_10mcd_Broadcom_HSMS-C170 ...modified attributes, part numbers etc for Orange LED ...same datash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
2021-08-14 added Ref_Adj_2V5-36V_Texas-Instruments_TL431LIAQ_SOT-23... ...copied from template, symbol copied zener then rest custom ...datasheet from TI website ...footprint uses KiCAD official Package_TO_SOT_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
2021-08-14 added TVS_Unidir_400W_SOD-123FL_Littelfuse_SMF4L--A... ...unidirectional version of existing bidirectional SM4FL ...copied and renamed, filled in attributes etc ...symbol copied from zener, but added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
2021-08-16 added Lake Parime silkscreen logo - footprint only... ...19.2mm x 2.5mm approx ...uses existing generic logo symbol ...imported from original logo .DXF, then added inner polygons manually :/
2021-08-18 added TestPoint_Pad_1.5mm... ...copied from TestPoint_Pad_1.3mm ...attribute changes, copied footprint, simple adjustments
2021-08-19 added SuperCap_SMD_2V6_11.5mF_3225_Seiko_CPM3225A... ...copied from SuperCap_SMD_3V3_11mF_3225_Seiko_CPH3225A ...+70C version needed for PT118A, lower voltage ...uses same footprint as CPH3225A ...da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
2021-08-19 added TestPoint_Pad_1.8x1.4mm_Oval... ...copied from TestPoint_Pad_1.5mm ...attribute changes, copied footprint, simple adjustments ...oval for PT118C to work well with PT118A spring contacts
2021-08-20 added Opamp_Single_1.2MHz_3.5V-16V_SMD_Microchip_MCP6H01_TDFN-8... ...copied SC-70-5 version, using 2x3mm TDFN improved thermals ...updated part attributes etc, modified pins to match TDFN-8 ...symbo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
2021-08-20 added LDO_Fixed_2V5_300mA_ON-Semi_NCP718_WDFN-6... ...copied from LDO_Fixed_5V0_300mA_ON-Semi_NCP718_WDFN-6 ...2.5V output version, only comes *with* active discharge ...modified part attributes etc 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
2021-08-21 added Pin9 for centre Exposed Pad EP for... ...Sensor_Cap_2Ch_GPIO_Microchip_MTCH102_UDFN-8 ...also set footprint Pin9 EP to solid contact
2021-08-22 added 2.20mm hole version of M2.0 mounting hole after customer request changed both TELOS logo footprints to 8.0x1.6mm after customer request... ...want horizontal on PT118A 4.0 4A, so needs to be sl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
2021-08-26 added 2.15mm NPTH mounting hole footprint for PT118C 3.0... ...copied and adjusted from MountingHole_M2.0_2.15mm_Pad3.8mm ...no pad / non plated, courtyard 0.25mm margin
2021-08-27 added NMOS_Single_55V_0.54A_SOT-23_Infineon_BSS670S2L... ...copied from NMOS_Single_20V_0.9A_SOT-416_ON-Semi_NTA4153NT1G ...attributes adjusted ...footprint use official KiCAD Package_TO_SOT_SMD:SOT-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
2021-09-02 added PMOS_Single_40V_7A_TO-252_Diodes-Inc_DMP4025LK3Q... ...copied NMOS_Single_55V_0.54A_SOT-23_Infineon_BSS670S2L ...symbol used from KiCAD Q_PMOS_GDS to match PMOS & pinout ...attributes etc chang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
2021-09-20 added Triac_Single_30A_600V_35mA_TO-263_ST-Microelectronics_T3035H... ...from template, symbol from KiCAD official Device:Q_TRIAC_A1A2G ...symbol modified style slightly ...footprint uses D2PAK/TO-26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
2021-09-21 added Header_4.20mm_TH_02x03_Vertical_Molex_462071006... ...copied Header_4.20mm_TH_02x03_Horizontal_Molex_39300060 ...Mini-Fit RTC reflow compatible, fits Mini-Fit Jr. ...chosen reflow version for s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
2021-12-27 converted symbol libaries to new v6.0.0 format... ...using kicad v6 library migration tool ...deleted old .dcm .lib file format updated sym-lib-table for new converted file
2021-12-28 converted .kicad_wks titleblocks to v6.0.0
2022-01-13 converted footprint libaries to new v6.0.0 format... ...optional as would update as they're used but cleaner all at once ...opened and re-saved all footprints to use updated v6 save schema updated fp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
2022-01-18 updated bom.ini from latest KiBOM generated template... ...but keeps the same customised functionality ...except alt_wrap removed so doesn't wrap fields... ...but don't think that worked anyway?
2022-01-18 added config.ini for InteractiveHtmlBom v2.4.1 ... ...latest version installed with kicad v6 plugin manager ...also added to documentation, together with other v6 stuff
2022-02-01 added Fiducial... ...symbol copied from officual KiCAD Mechanical:Fiducial ...added part attributes etc ...pointed to use new footprints, default 3mm wide mask one copied two Fiducial footprints from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
2022-02-01 added keepout zones to all footprints in library where needed... ...replaced old lines on Dwgs.User layer, keepout native in v6 ...different layers/rules depending on component RJ45-Mag_100Base-TX_Ho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
2022-02-02 added 'net tie' keyword to PCB antenna & NFC footprints... ...to avoid KiCAD v6 DRCs for internal footprint copper connections
2022-02-16 James Head first iteration for PT128 library parts: in temp _JH folders/libraries for now (except datasheets & 3D STEP models)
    For chosen parts:
    Molex 2171770001
    AVX 009176003032906, with 009176003032106 as secondary-source
    Diodes Inc AP3012KTR-G1
    ON Semiconductor NSR05T40P2T5G
    Bourns CG0402MLA-14LG
    Laird TYA201610 Series (will use 10uH TYA201610100M-10)
    Bel Fuse 0ZCK Series (will use 0.35A 0ZCK0035FF2G)
    --------------------------------------------------------
    WORK DONE
    Molex 2171770001
    footprint downloaded from Samacsys/Component Search Engine
    step model downloaded from Molex website
    AVX 009176003032906
    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
2022-02-16 James Head PT128 part changes after my review comments:
    Pad styles changed to rounded rectangles.
    Edited symbol and footprint for USB-C connector. Changed large holes to slots. Reduced courtyard. Added PCB Edge. Changed pin types in symbol. Swapped datasheet to drawing.
    SODFL100X60X40L19X20_ONSEMI
    Edited text sizes. Copied values from the existing Metric 1005 capacitor from Kevin's library.
    VARC100X50X60L25_BOURNS
    Edited text sizes. Copied values from the existing Metric 1005 capacitor from Kevin's library.
    SOT23-5P95_285X140L45X42_DIODES
    Edited text sizes. Copied values from existing SOT-353_SC-70-5_W1.25xL2.0xH1.1mm_P0.65mm from Kevin's library
    IND_LAIRD_TYA201610
    Edited text sizes. C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
2022-02-16 moved all James Head PT128 parts as-is to main libraries... ...TODO still each need review & modification before useable! ...deleted _JH symbol/footprint libraries/folders
2022-02-16 corrected footprint references for all new PT128 parts
2022-02-16 Inductor Laird TYA201610 Series part changes... ...renamed to Inductor_SMD_2016_0.24-15uH_4.5A-0.36A_WireWound_Shielded_Laird_TYA201610 ...renamed datasheet, footprint, symbol ...corrected descriptio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
2022-02-16 review and corrected Molex 2171770001... ...renamed to USBx-C_Single_Horizontal_SMD_MidMnt_Receptacle_Molex_2171770001 ...deleted abberant part field 'Height', added missing fields ...renamed symbol 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
2022-02-16 review and fixes for AVX 009176003032906... ...renamed to Header_IDC_4.00mm_SMD_01x03_Vertical_AVX_009176003032906 ...changed datasheet & footprint name, whole series not just part ...added mouser pa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
2022-02-16 review and fixes for On Semiconductor NSR05T40P2T5G... ...renamed to Schottky_Single_40V_0.5A_ON-Semi_NSR05T40P2_SOD-923 ...renamed datasheet and added link in part ...footprint renamed to SOD-923 ..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
2022-02-16 Diodes Inc AP3012 part review and fixes... ...renamed to DCDC_Boost_Converter_2V6-16V_0.5A_1500kHz_Diodes-Inc_AP3012_SOT-23-5 ...made symbol smaller, added overbar to SHDN pin ...added missing symbol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
2022-02-16 review and fixes for Bel Fuse 0ZCK Series PTC Polyfuse ...renamed to FusePTC_0.10A-1.1A_SMD_2012_Belfuse_0ZCK ...changed part for whole series rather than single part ...changed symbol same as KiCAD 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
2022-02-16 review and fixes for CG0402MLA-14LG... ...changed to correct voltage part(!) CG0402MLA-14LG ...renamed to Varistor-ESD_SMD_0402_1005m_14VDC_Bourns_CG0402MLA-14LG ...fixed description to apply to this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
2022-02-19 added footprints for library parts 'Capacitor_SMD_0805_2012m' and 'Resistor_SMD_0805_2012m'... ...including IPC Least versions ...footprints created in PCB Library Expert Pro 2020.02... ...for +/-0.2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
2022-02-19 removed centre courtyard cross made by PCB Expert... ...causes DRC errors "courtyard is not a closed shape"
2022-06-19 Added LDO_Adjustable_500mA_STMicro_LD39050_DFN-6 - copied from LDO_Adjustable_2A_STMicro_LD39200_DFN-6 - added datasheet - footprint is compatible with old part
2022-06-21 Modified BM833 footprint to be a combination of V0.9 and V1.07 Datasheets Added V0.9 datasheet due to requiring full information in repo for future.
2022-06-24 Created D1213A-04S-7 - Footprint based SOT-353_SC-70-5_W1.25xL2.0xH1.1mm_P0.65mm - Symbol based on TVS_Bidir_Dual_HighSpeedData_ST-Micro_USBLC6-2_SOT-666
2022-06-24 Updated 3D model position based on datasheet error footprint change
2022-07-02 BT_SMD_PCBAntenna_Fanstel_BM833 minor changes during review... ...adjusted copper keepout area to match latest v1.07 datasheet ...X distance target 5.0mm nominal = 4.75mm to silk incl X tolerance (wa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
2022-07-03 review of D1213A-04S for PT115... ...renamed for unidirectional (USBLC6-2 copied from was wrong)... ...to TVS_Unidir_Quad_HighSpeedData_Diodes-Inc_D1213A-04S_SOT-363-6 ...copied attribute description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
2022-07-23 Created DFN1006-3_W0.62xL1.02xH0.5mm_P0.35mm_Nexperia_SOT883.kicad_mod - Followed manufacturers recommended footprint from Nexperia NX7002BKM Single 350mA 60V N-Channel MOSFET.pdf - Created for PMOS_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
2022-07-24 Added TestPoint_TH_1.3mm_0.7mm symbol and footprint
2022-07-24 Added C2Q series fuse to library for use on PT128A
2022-07-27 review and adjustments for PT128A FETs BSS84AKM and NX7002BKM... ...modified footprint pads 0.225mm instead of 0.25mm datasheet ...to give 0.125mm clearance for less onerous design rules ...moved pad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
2022-07-27 minor changes after review of TestPoint_TH_1.3mm_0.7mm... ...set desciption and value fields to match footprint ...added details about design intent for 26AWG ...made Silk text 0.8mm high as min gene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
2022-07-30 renamed footprint for Fuse_0.25A-5A_SMD_1608_Belfuse_C2Q... ...to reflect 0.48mm (05) footprint package height
2022-08-24 added Opamp_Quad_0.15MHz_1.5V-5.5V_SMD_STMicroelectronics_TSV714_QFN-16... ...copied part from TEMPLATE_ic-amplifiers ...copied symbol from Opamp_Single_1.2MHz_3.5V-16V_SMD_Microchip_MCP6H01_SC-70-5 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
2022-08-26 adjusted footprint used in PT115A to improve soldermask... ...need 0.20mm pad-pad to give 0.10mm min mask web w/ 0.05mm margin changed footprint for Sensor_IMU_I2C-SPI_STMicroelectronics_LSM6DSL_LGA-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
2022-11-15 adjusted footprint used in PT115A... ...to remove silkscreen-soldermask overlap LGA-14L_W3.0xL2.5xH0.86mm_P0.5mm_ST-Micro.kicad_mod
2022-11-29 added Header_1.00mm_SMD_01x02_Horizontal_JST_SH-SR... ...copied Header_2.00mm_SMD_01x02_Horizontal_JST_PH ...modified to suit SR series (SH interchangeable) ...footprint copied from KiCAD official JS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
2022-12-08 added OR-2_Quad_2V0-6V0_Texas-Instruments_SN74HCS32_WQFN-14... ...copied from TSSOP-14 version library part & symbol ...added Pin15 UnitE EP pad, changed part attributes etc ...footprint made with Fo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
2022-12-09 added TestPoint_Pad_0.8mm... ...copied from existing, modified accordingly, simple ...changed this & 0.9mm silk to 0.10mm thick, was 0.12mm
2022-12-09 added SolderBridge-2_0.65x1.0mm_Bridged ...copied from misc template, symbol SolderJumper_2_Bridged ...made pin num text smaller, narrow to match chip R&C size ...fp copied SolderJumper-2_P1.3mm_Brid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
2022-12-14 added PMOS_Dual_12V_3.8A_DFN2020-6_Diodes-Inc... ...copied from NMOS_Dual_60V_8A_PowerPAK-SO-8_Vishay_Si7972DP ...adjusts to PMOS, pins, attributes etc to match ...datasheet from Diodes Inc website .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
2022-12-28 added Fuse_0.50A-8A_SMD_1608_Belfuse_C2F... ...copied from C2Q fuse, changed attributes etc ...datasheet from belfuse website ...footprint, 3D model used same (almost identical) ...made generic for w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
2023-03-16 added Button_Push_SPST_Horizontal_SMD_Panasonic_EVQP7L01P... ...datasheet and 3D model from official Panasonic ...fp & 3D named to fit both EVQP7L01P and EVQP7C01P (1.6N vs 2.2N) ...symbol copied But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
2023-03-16 fix Button_Push_SPST_Horizontal_SMD_Panasonic_EVQP7L_EVQP7C courtyard
2023-03-17 added TVS_Unidir_Quad_HighSpeedData_Diodes-Inc_DT1240-04LP_DFN2510... ...symbol copied TVS_Unidir_Quad_HighSpeedData_Diodes-Inc_D1213A-04S_SOT-363-6 ...plus custom made symbol graphics from other par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
2023-03-21 fixed DFN1006-3_W0.62xL1.02xH0.5mm_P0.35mm_Nexperia_SOT883.kicad_mod for NMOS_Single_60V_0.35A_DFN1006-3_Nexperia_NX7002BKM footprint pin1-2 spacing didn't match datasheet also made Fab polarity mark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
2023-03-22 added NMOS_Single_20V_0.6A_DFN1006-3_Nexperia_PMZ600UNE... ...copied NMOS_Single_60V_0.35A_DFN1006-3_Nexperia_NX7002BKM ...edited attributes etc, symbol design kept the same ...datasheet from officia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
2023-05-05 added LDO_Fixed_3V3_300mA_Texas-Instruments_TLV733P_X2SON-5... ...copied LDO_Fixed_3V3_300mA_Texas-Instruments_TPS7A25_WSON-6 ...changed part attributes, pins etc to match TLV733P DQN ...datasheet an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
2023-05-24 added LED_SMD_1610-Horizontal_Blue_2.8V_440mcd_Dialight_598-8D... ...copied LED_SMD_1608_Green_3.2V_430mcd_Wurth_150060GS75000 ...customised part attributes etc ...updated drawing, graphs; dialight s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
2023-05-26 added Ref_Fixed_1.25V_ST-Microelectronics_TS4061A_SOT-323... ...copied Ref_Adj_2V5-36V_Texas-Instruments_TL431LIAQ_SOT-23 ...changed part attributes, marked Pin3 NC (not Ref) ...datasheet from ST web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
2023-05-26 added Header_2.54mm_TH_01x09_Horizontal_TE-Connectivity_5-103361-7... ...copied Header_2.54mm_TH_01x09_Vertical ...renamed and changed attributes ...datasheet drawing and 3D model from TE website ...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
2023-05-27 fixed 3D model paths in footprints... ...replaced KISYS3DMOD with KICAD6_3DMODEL_DIR
2023-06-07 changed 3D model for PMOS_Dual_12V_3.8A_DFN2020-6_Diodes-Inc... ...changed to one finally supplied by Diodes Inc support ...has big offset but think OK?
2023-06-29 first basic kicad timelapse script... ...exports PNG images of KiCAD PCB from X recent commits
2023-07-05 renamed to work with latest >= v2.5.0 version... ...of Interactive HTML BOM plugin
2023-08-08 ****Convert v7 KiCAD format for all symbols... ...no changes needed for other library files
2023-08-10 saved titleblock to V7 kicad format set heatsink fabrication property on all centre pads set solid plan gnd contact on all centre pads
2023-08-13 first version of design pack export python script... ...uses KiCAD v7 CLI (Command Line Interface)
2023-08-13 Update README.md
    update for KiCAD v7 and LTD
2023-10-04 added modules-plugin library renamed existing 'module' to modules-smd (footprint & 3d models only)
2023-10-05 added footprints for CM4 sockets (separate commit for module & symbols)... ...footprint created custom to match recommended in datasheet ...corrected lots of things missing in CM4 IO footprint ...cre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
2023-10-05 added CM4 component (separate for module & two connectors)... RPi_CM4_Module RPi_CM4_Connector1-100_GPIO RPi_CM4_Connector101-200_HighSpeed copied from CM4IO part, but split into 3 and many changes/f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
2023-10-14 added Protection_Output_HighSideSwitch_Single_0.13A-2.7A_3V0-5V5_Diodes-Inc_AP22653_DFN-6 ...Active-high enable version (AP22653) ...from existing active-low /enable part (AP22652) ...updated datashe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
2023-10-19 added USB3_PCIe-Host-Quad_ViaLabs_VL805_QFN-68... ...symbol copied & adapted CM4IOUSB3-KiCAD ref design ...footprint same as used in CM4IOUSB3-KiCAD ref design ...but non-thermal via version ...Packa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
2023-10-20 added Crystal_25MHz_SMD-4_2016_10ppm_20ppm_10pF_ECS_ECX-1637B copied from existing 32MHz in library of same series uses same symbol, footprint, datasheet, 3d model etc
2023-10-20 added Ferrite_SMD_1608_0.7A_220R_Murata_BLM18AG221SN1D... ...copied & adjusted from existing BLM18PG121SN1D same series ...existing symbol, footprint, datasheet etc
2023-10-25 added TPU_SMD_Google_Coral_G313-06329-00_LGA-88-32EP... ...symbol & footprint adapted from: https://github.com/will127534/Coral-USB3-M2-Module ...3D STEP from google-coral/mechanicals/ repo (dev_boar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
2023-10-25 added FanControl_SMBus_Microchip_EMC2101_MSOP-8... ...symbol from scratch from library template ...footprint uses KiCAD official MSOP-8 and 3D model ...datasheet from microchip website ...non '-R' ve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
2023-10-27 added Varistor-ESD_SMD_0603_1608m_18VDC_Bourns_CG0603MLA-18KE... ...copied and adj existing CG0402MLA-14LG symbol & footprint ...uises existing datasheet, 3d model
2023-10-30 added TerminalBlock_Pluggable_5.08mm_TH_01x02_Horizontal_CamdenBoss_CTBP9358-2.kicad_mod ...for CTBP9358/2 based on similar TE Connectivity 796638-2 ...attributes adjusted to match cb part ...fp hole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
2023-10-30 added TerminalBlock_Pluggable_3.81mm_TH_01x04_Horizontal_CamdenBoss_CTBP93HE-4 added TerminalBlock_Pluggable_3.81mm_TH_01x02_Horizontal_CamdenBoss_CTBP93HE-2 ...symbol based on Wurth 691322110002 exi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
2023-10-31 added TerminalBlock_Pluggable_3.81mm_TH_01x03_Horizontal_CamdenBoss_CTBP93HE-3.kicad_mod ...missed 3way version before due to ticket typo ...adapted previous symbol part & footprints etc ...3D STEP m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
2023-11-08 added Protection_Output_HighSideSwitch_Single_7A_2V7-23V_Texas-Instruments_TPS25970L_VQFN-10 ...based on existing TPS1H100A part & modified ...datasheet & 3D model from TI website ...footprint custom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
2023-11-11 added USB3_SATA_Bridge_Texas-Instruments_TUSB9261I_QFP-64-1EP ...datasheet & 3D model from TI website ...symbol done custom from template ...footprint used PCB Footprint Expert 2023v13
2023-11-13 modified USB3_SATA_Bridge_Texas-Instruments_TUSB9261I_QFP-64-1EP... ...swapped USB N/P symbol order for better schematic wiring
2023-11-13 added Oscillator_40MHz_SMD-4_2520_10ppm_85C_ECS-Inc_ECS-2520S18... ...1V8 40MHz based on previous 3V3 26MHz part in same series ...re-uses existing footprint, symbol, 3D model, datasheet
2023-11-13 renamed to Protection_Output_HighSideSwitch_Single_7A_2V7-23V_Texas-Instruments_TPS25974L_VQFN-10 Changed part from TPS25970L to TPS25974L... ...renamed & change part attributes and pin numbers
2023-11-17 added Notecard module and connector
2023-11-22 added Sensor_AccelMag_I2C-SPI_STMicroelectronics_LSM303AGR_LGA-12L... ...symbol adapted from existing LSM6DSL ...new custom footprint with learnings from 'LGA-14L' ...pads target 0.35x0.375mm for TN0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
2023-11-22 added RTC_I2C_Microchip_MCP79410_MSOP-8... ...symbol adapted from PCF8523 existing part ...uses official KiCAD MSOP-8 3x3mm package (checked) ...datasheet from official Microchip website
2023-11-23 added M2 footprints (as they came from POD gen service)... ...need thorough checking, combining with symbol parts ...as well as text tidying, courtyard 0.25mm sorting ...part re-naming, adding datash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
2023-11-23 added Buffer_Dual_1V65-5V5_Texas-Instruments_SN74LVC2G34_SC-70-6... ...symbol drawn custom, attributes entered ...datasheet from TI website ...footprint uses official Kicad (checked)
2023-11-23 added IO_Isolated_Dual_Digital-Isolator-4Mbps_Texas-Instruments_ISO7021_SOIC-8... ...based on existing ISO1212, adjusted ...uses KiCAD official library footprint (checked) ...datasheet from TI website
2023-11-24 Notecard edge connector tidied and name clarification
2023-11-25 fixed pin number error on MDT420E01001
2023-11-25 fixed pin direction of Notecard connector
2023-11-27 added NMOS_Single_40V_50A_TO-252_Vishay_SUD50N04-8m8P... ...datasheet from vishay website, footprint kicad official
2023-11-27 added Ideal_Diode_Controller_AnalogDevices_LTC4373I_MSOP-8... ...symbol custom made, datasheet from analog website ...footprint use official kicad (checked)
2023-11-27 finalised M.2 'E' and 'M' key conn socket footprints... ...text smaller, better courtyard, similar outlines ...added manufacturer 3D models & checked over ...renamed to be descriptive, misc other fix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
2023-11-28 added footprint for TI BQ24070 / BQ24071... ...generated with PCB Footprint Expert POD service ...tidying adjustments to pad shapes, text sizes etc ...TODO: needs renaming, 3D STEP adding, link in sy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
2023-11-30 added BQ24070 footprint, symbol and 3D model
2023-11-30 added Standoff_SMD_M3_M.2-4.2H... ...SMT threaded M3 standoff for M.2 Drives e.g. SATA SSD ...for M2 sockets of 4.2mm height (standoff height 2.45mm) ...symbol and footprint done custom ...datasheet 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
2023-11-30 set standoff hole to solid plane contact... ...also functions as thermal path for SSD
2023-11-30 added Assembly_Generic... ...**FILL IN** Generic Assembly ...part external to PCBA (NO FOOTPRINT) ...to include in BOM
2023-11-30 added M.2 card edge drawing line to M.2 socket footprints
2023-11-30 added M.2_2280_Card_Generic... ...for M.2 plugin assembly on BOM but not soldered to PCBA ...for silkscreen, outline, courtyard etc (no pads)
2023-11-30 added M.2_3035_Card_Generic... ...for M.2 plugin assembly on BOM but not soldered to PCBA ...for silkscreen, outline, courtyard etc (no pads) ungrouped some 2280 card stuff
2023-12-01 added Heatsink_PushPin_19x19mm_Wakefield-Vette_960-19-15-D-AB-0... ...chosen diagonal for availability (confirm at layout/test) ...datasheet & 3D STEP model from official support ...symbol & footprin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
2023-12-02 added LED_SMD_2012_Blue_3.3V_100mcd_Kingbright_KPT-2012QBC-D... ...symbol copied from existing LED part ...datasheet from official site ...reused existing 2012 led footprint
2023-12-03 changed M.2_3035_Card_Generic to M.2_3035-42_Card_Blues_Notecard... ...extended footprint to support Notecard 35mm & 42mm models... ...made specific to Notecard rather than fully generic ...added Not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
2023-12-04 fixed LED description for... ...LED_SMD_2012_Blue_3.3V_100mcd_Kingbright_KPT-2012QBC-D
2023-12-04 added PMOS_Single_20V_0.76A_SOT-416_ON-Semi_NTA4151PT1G... ...copied from existing NTA4153, changed attributes & symbol ...re-uses same SC-75/SOT-416 footprint, official datasheet corrected symbol (w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
2023-12-05 added battery modules plugin
2023-12-05 added footprint to Notecard symbol
2023-12-05 added DCDC_Buck_Converter_2V7-6V_3A_Texas-Instruments_TPS628513_SOT-583... ...symbol custom made ...datasheet & 3D STEP from TI website ...footprint copied official kicad & adjusted
2023-12-06 added Standoff_SMD_M2.5_M.2-4.2H_Wurth_9774025151R... ...symbol based on M3 Standoff and adjusted ...added datasheet & 3D STEP model from Wurth ...used Wurth Eagle footprint & adjusted... ...note; is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
2023-12-08 updated Li-Ion battery and added datasheet
2023-12-08 added DCDC_Buck_Converter_4V-36V_5A_1100kHz_Texas-Instruments_LMR51450S_WSON-12... ...datasheet and 3D model from official website ...footprint made using Footprint Expert POD + adjusted ...symbol cu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
2023-12-09 added SolderBridge-2_1.0x1.3mm_Bridged added SolderBridge-2_1.0x1.3mm_Open adjusted existing notes to add bridge thickness
2023-12-19 fixed notecard connector library part... ...renamed from Notecard_card-edge_Connector-67 ...to M.2_3035-42_Card_Blues_Notecard_Connector-67 ...removed KEY pins from symbol (netlist errors) ...narrowe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
2023-12-19 changed CM4 parts to use 3.0mm stack height instead of 1.5mm added CM4 connector footprints for 3.0mm stacking height version... ...copied & modified existing, allows 1.5mm clearance underneath ...ad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
2024-01-08 set all coral centre pads to solid contact (heatsink prop)
2024-01-09 changed to TUSB9261 QFP-64 footprint... ...change to 0.20mm pads to allow decent 2ox design rules ...change centre pads to solid plane contact / heatsink prop
2024-01-09 changed centre pads from 0.45mm to 0.35mm... ...different to manufacturer recommended ...but allows much better design rules ...also set to solid zone connection (gnd) ...has incidentally updated foo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
2024-01-11 added USB3.2-C_Single_Vertical_SMD_Receptacle_GCT_USB4160-03-0170... ...symbol copied USB3.1-C_Single_Horizontal_SMD_Receptacle_Amphenol_12401610E4-2A ...footprint custom made ...3D model and drawing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
2024-01-12 added Header_2.00mm_SMD_01x02_Vertical_JST_PH... ...symbol copied Header_2.00mm_SMD_01x02_Horizontal_JST_PH ...footprint made custom using horizontal as base ...datasheet existing, 3D STEP model from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
2024-01-16 added Ideal_Diode_Controller_Texas-Instruments_LM74700-Q1_SOT-23-6... ...datasheet from TI website ...symbol custom based on existing Ideal Diode ...footprint uses official KiCAD SOT-23-6
2024-01-24 added PMOS_Single_30V_3.8A_SOT-23_Diodes-Inc_DMP3099L... ...symbol copied other PMOS and adjusted pinout etc ...datasheet from Diodes Inc website ...footprint etc from kicad official (checked)
2024-01-25 fix Charger_Lithium_and_power_path_BQ2407x ... ...don't use hidden pins!! ...caused issue with pin name setting net name ...blocker for assigning net classes based on name ...needs a lot more fixing 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
2024-01-25 fix RPi_CM4_Module stacking height to 3.0mm... ...to match previous change to CM4 connectors
2024-01-31 added SIMCard_Nano_Hinged_WithSwitch_GCT_SIM8060.stp... ...symbol copied KiCAD official SIM_Card & adj ...datasheet and 3D model from GCT website ...footprint from SnapEDA (GCT official link) with ma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
2024-02-01 added PCB_Silk_Logo_GiraffeCCTV footprint converted from youtube video logo screenshot with kicad bitmap converter
2024-02-07 added TVS_Unidir_200W_SOD-964_Nexperia_PTVS15VZ1USK... ...symbol copied from other TVS, entered attributes ...footprint from Footprint Expert POD & modified ...datasheet and 3D model from Nexperia we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
2024-02-07 added MCU_SMD_32Bit_ARM-M0_256KB_32KB_STMicro_STM32F030_LQFP-64... ...copied ic-processor template ...symbol from KiCAD official STM32F030RCTx then modified ...(kept all pins explicit, e.g. VCAP to a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
2024-02-13 improved footprints to reduce DRCs... ...TagConnect made keepout area smaller
2024-02-13 updated design pack export script to fix PDF export drill marks... ...now the PDF will match the gerbers around drills ...previously had a hole missing in drills ...requires KiCAD v7.0.8 with new com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
2024-02-14 modified CM4 Hirose DF40 footprints to reduce DRCs... ...separate mask into its own 'SMD aperture' pad ...to work around KiCAD v7.0.8 issue
2024-02-15 fix Charger_Lithium_and_power_path_BQ2407x... ...added 3D model reference ...still needs tidying (naming, remove AndyW footprint etc)
2024-02-15 modified script to subtract soldermask from silkscreen also disable aperture macros, looks funky... ...prefer basic just in case (only minor size diff)
2024-02-16 KICAD PCB timelapse script improvements... ...added setting SVG inkscape opacity (visual clarity) ...set up for PT136A with 4layer board (but not GND In1) ...added some clarifying comments ...change 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
2024-02-19 KICAD PCB timelapse script improvements... ...changed to only use commits where kicad_pcb changed, not all ...will also now discover up to max of commit number given ...added silkscreen to layers out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
2024-03-04 added Cell-Holder_18650_Horizontal_TH_Keystone_1043P ... ...symbol copied existing, footprint created custom ...datasheet & 3D model from Keystone website
2024-03-08 tidy up AW library parts... ...remove Battery_19x69mm_Lithium-Ion_Rechargeable_2.6Ah ...unfinished, unused
2024-03-08 tidy up AW library parts... ...remove Power_Mux_SPDT_5V5_Texas-Instruments_TPS2115APW_TSSOP-8 ...unfinished, unused
2024-03-13 tidy up AW library parts (BQ24070)... ...renamed Charger_Lithium_and_power_path_BQ2407x to ChargerPowerPath_Lithium_Single_2A_4.4V_BQ24070_VQFN-20 ...deleted unused footprint VQFN-20_W3.5xL4.5mm_P1.0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
2024-03-21 added EEPROM_8Kbit_I2C_DFN-8_ST-Micro_M24C08-F... ...datasheet from official ST site ...footprint from Footprint expert POD and adjusted ...symbol created custom ...3D model from kicad offical
2024-04-10 added Eth_Switch_5Port-10-100_ICPlus_IP175GHI_QFN-48-1EP... ...symbol custom, partially from Simon @ RN Meerkat PCB ...footprint & 3D model uses official kicad ...datasheet from LCSC (only source eas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
2024-04-11 added Crystal_25MHz_SMD-4_3225_10ppm_15ppm_10pF_ECS_ECS-33B... ...for 40R max ESR of eth switch IP175GHI ...3D STEP model from kicad official ...datasheet from ECS website ...footprint from Footprint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
2024-04-13 updated all fp & sym libraries to kicad v8.0.1, using... kicad-cli fp upgrade kicad-cli sym upgrade
2024-04-13 updated drawing titleblock sheet to kicad v8.0.1 ... ...needed to re-scale logo image to match correct size removed legacy KBconsulting titleblock updated readme for v8
2024-06-17 added Crystal_8MHz_SMD-4_3225_10ppm_30ppm_10pF_ECS_ECX-32... ...datasheet from official ECS ...footprint from footprint expert 23 POD ...symbol and attributes copied & modified from ECS-33B ...3D STE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
2024-06-17 added Schottky_Single_40V_0.2A_ON-Semi_NSR0240P2_SOD-923... ...datasheet from ONSemi official ...footprint re-use existing SOD-923 (same OnSemi package) ...copied NSR05T40P2 (obsolete) and adapted, 2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
2024-06-28 added ChargerPowerPath_Lithium_Single_3A_Buck_BQ25622E_WQFN-18... ...datasheet from TI official ...symbol half/half copied existing & Simons BQ25622[E] ...footprint from FootprintExport POD & adjuste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
2024-07-04 ChargerPowerPath_Lithium_Single_3A_Buck_BQ25622E_WQFN-18 slightly adjusted pin spacing
2024-08-05 added TVS_Bidir_10kV_SOD-882_Nexperia_PESD24VF1BBL... ...datasheet from official website ...symbol copied & adjusted, entered attributes ...3D model from KiCAD library ...footprint from Footprint Exp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
2024-08-05 TVS_Bidir_10kV_SOD-882_Nexperia_PESD24VF1BBL... ...minor footprint adj (added fab bi-dir icon)
2024-08-13 added Multi-Func_Single_Schmitt_1V65-5V5_Nexperia_74LVC1G98_SOT-363... ...symbol created fully custom ...footprint & 3D existing library SOT-363 (close enough) ...datasheet from official Nexperia web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
2024-09-06 added Socket_ZIF_0.5mm_SMD_01x24_Horizontal_Wurth_687124182122... ...work in progress (awaiting POD footprint)
2024-09-06 Revert "added Socket_ZIF_0.5mm_SMD_01x24_Horizontal_Wurth_687124182122..."
    This reverts commit d13b1857ad8c822d44d91a1d24b5f001c555a02a.
2024-09-08 added Socket_2.54mm_TH_01x04_Vertical (copied from existing and modified) uses kicad library footprint
2024-09-08 added Socket_2.54mm_TH_01x02_Vertical (copied from existing and modified) uses kicad library footprint
2024-09-13 added 'Legs' Tag Connect version footprint will add full part/symbol to use this next
2024-10-17 added Ferrite_SMD_1005_0.9A_600R_Murata_BLM15PX601SN1D ... ...copied from existing BLM15 part and modified ...same footprint, datasheet, 3d model
2024-10-19 added Button_Push_SPST_Vertical_SMD_CandK_NANOT240AS ... ...copied and modified part from FSM8JSMA ...datasheet and 3D model from official C&K / Littelfuse website ...footprint created custom based o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
2024-10-25 added Cell-Holder_Negative_CR12-CR16_Horizontal_SMD_Keystone_118 added Cell-Holder_Positive_CR12-CR23_Horizontal_SMD_Keystone_120 ...done as separate positive/negative contacts for BOM ...each copied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
2024-10-30 added DCDC_Boost_Converter_0V5-5V5_1.2A_3000kHz_Texas-Instruments_TPS61299A_SOT-563... ...datasheet from TI website ...symbol copied from another & adapted ...footprint from footprint expert POD & ad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
2024-11-08 added TagConnect_6pin_UART_Legs For whole range of TagConnect FTDI UART 'Legs' cables Note: VCC voltage & direction, UART voltages & speed etc depend on cable chosen - not all are compatible with all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
2024-11-27 removed numbers from TagConnect symbols (misleading when mirrored) added extra holes to symbol for legs version
2024-12-09 correct Resistor_SMD_0201_0603m power from 63mW to 50mW in description
2025-02-04 updated design pack script for kicad v8, add Flex layer options PdfMerger deprecated, replace with PdfWriter for PCB PDF export not yet including v8 native BOM export or other changes
2025-02-12 added BOM to export script, v8+ native BOM export feature verified equivalent on PT136A 3.0 3A, with notes: - changes the export order - delimeter quotes on all fields, not just essential - empty fie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
2025-02-14 updated library 3D model KICAD7_ & KICAD6_ to KICAD8_ verified didn't affect models (some existing issues) fixed misc issues incl .wrl to .step, renamed 3D model
2025-02-14 upgrade all symbol & footprint kicad v8.0.8 format using kicad-cli sym[/fp] upgrade --force
2025-02-19 added Audio_Stereo_10W_7V-18V_SMD_AnalogDevices_SSM3302_QFN-40-1EP... ...symbol created custom, datasheet from official website ...footprint uses existing KiCAD official ...(EP width & body height v 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
2025-02-21 added CommonModeChoke_SMD_5050_5A_250R_Murata_DLW5BTM251SQ2 ...symbol based on existing kicad library one ...footprint from snapmagic (linked from murata), adjusted ...3d model from snapmagic ...data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
2025-02-21 Audio_Stereo_10W_7V-18V_SMD_AnalogDevices_SSM3302_QFN-40-1EP... adjusted THERM pin active-low (datasheet error) https://ez.analog.com/audio/f/q-a/4082/ssm3302-therm-pin
2025-05-06 added MCU_SMD_32Bit_ARM-M33_1024KB_786KB_STMicro_STM32U575_LQFP-64... ...copied ic-processor template ...symbol from KiCAD official STM32U575RGTx then modified ...(kept all pins explicit) ...uses exi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
2025-05-07 added Button_Push_SPST_Vertical_SMD_CIT_CS1213AGF160... ...symbol copied existing momentary switch ...fooptprint from footprint expert but most aspects manual ...datasheet from official website ...3D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
2025-05-09 added Standoff_SMD_M2.5_CM4-3.0mm_Wurth_9774030151R... ...datasheet & 3D model from Wurth official ...symbol & footprint copied from existing & modified minor description correction in 2.5mm height s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
2025-05-09 RPi_CM4_Module remove 4off plain mounting holes... ...now uses separate parts Standoff_SMD_M2.5_CM4-3.0mm_Wurth_9774030151R
2025-07-07 added ChargerPowerPath_LithiumLeadAcid_55V_BuckBoost_AnalogDevices_LTC4020I_QFN-38-1EP ...symbol custom, footprint from footprint expert with mods ...3d model from ultralibrarian(linked official) ...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
2025-07-08 added EthMagnetics_SMD_PoE_10-100_Bourns_SM13126PEL... ...symbol based on KiCAD official PT61017PEL plus mods ...footprint from footprint expert with mods ...datasheet & 3d model from official Bourns
2025-07-08 added Capacitor_SMD_1808_4520m library part... ...same as other large ones, uses kicad official footprint
2025-07-08 Fix CommonModeChoke_SMD_5050_5A_250R_Murata_DLW5BTM251SQ2... ...move marking to over Pin3-4 to match datasheet (confusingly) ...functioned OK (reversible polarity, but ensures correct pin#'s) ...also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
2025-07-09 added modules-th footprint & 3d models library... ...no schem library (soldered parts; sort per function)
2025-07-09 added Eth_PoE_PSE_TH_Module_Silvertel_AG6120... ...symbol created custom ...datasheet & 3D model from Silvertel official ...footprint from Footprint Expert (modified) ...TH hole 1.1mm per datasheet (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
2025-07-09 AG6120 increased courtyard tolerance from 0.25mm to 0.5mm
2025-07-09 added Eth_PoE_DCDC_TH_Module_Silvertel_Ag7200... ...symbol created custom ...datasheet & 3D model from Silvertel official ...datasheet accidentally commited last commit ...footprint from Footprint Ex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
2025-07-09 added Al-Elec_Polarised_Radial_TH_63V_47uF_D6.3xP2.5xH11.0mm_Rubycon_YXJ ... ...simple copy & edit 63V 47uF version (existing 50V 47uF) ...same datasheet, footprint, 3d model ...only differs in volta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
2025-07-10 move ADJ pin Eth_PoE_DCDC_TH_Module_Silvertel_Ag7200
2025-07-10 added TerminalBlock_Screw_3.81mm_TH_01x05_Horizontal_TE-Connectivity_284392... ...datasheet same as other in series ...symbol & footprint modified from existing, for 5way ...3D model from official TE
2025-07-10 fixed Eth_Switch_5Port-10-100_ICPlus_IP175GHI_QFN-48-1EP... ...3D model missing after kicad official 3D model removal ...created new footprint with Footprint Expert & mod ...and attached different ki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
2025-07-11 added BJT_NPN_Single_65V_0.1A_SOT-323_Nexperia_BC846BW... ...datasheet from official Nexperia/NXP ...footprint & 3D model use existing footprint (checked) ...checked pin order, entered part details .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
2025-07-11 fixes for QFN-48-1EP_W6.0xL6.0xH0.9mm_P0.4mm_EP4.3x4.3mm_ICPlus_IP175GHI... ...adjusted QFN pads, to meet 0.2/0.2mm design rules for 0.4mm... ...was 0.72mm x 0.22mm, now 0.80mm x 0.20mm ...changed to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
2025-07-17 added RJ45-Mod_100Base-TX_Horizontal_TabUp_TH_Amphenol_RJHSE-5F81 ...symbol custom, copied existing and modified ...datasheet and 3D model from amphenol official ...footprint from snapmagic (linked o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
2025-07-29 RJ45-Mod_100Base-TX_Horizontal_TabUp_TH_Amphenol_RJHSE-5F81... ...modify footprint pin pads; now 1.40mm, was 1.50mm ...allows 0.20/0.20mm track/gap between pins
2025-07-30 EthMagnetics_SMD_PoE_10-100_Bourns_SM13126PEL... ...adjusted footprint to remove forced keepout area ...will do on a more case-by-case design basis
2025-09-02 updated symbol libraries for KiCAD v9.0.4 using; kicad-cli sym upgrade --force INPUT_FILE
2025-09-02 updated footprint libraries for KiCAD v9.0.4 using; kicad-cli fp upgrade --force INPUT_FILE
2025-09-02 updated worksheet & readme for KiCAD v9.0.4
2025-09-02 update KiCAD v9 footprint 3D model paths
2025-09-04 added PCB_Mask_Logo_vSMSC_7mm footprint added PCB_Silk_Logo_vSMSC_11.5mm footprint converted from existing PCB design library parts simplified polygons and put in my library
2025-09-05 added Mobile_4G_SMD_SimCom_SIM7600E_LCC-87... ...symbol & footprint copied from PT140A existing & adapted ...symbol split into 2 units, fixed some pin types ...footprint fixed lots; Pin1 keepout, Fab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
2025-09-25 added Mux8-1_SPST_Texas-Instruments_TMUX1208_QFN-16 ...symbol copied KiCAD official and adapted (Pin1 NC) ...datasheet & 3D model (UltraLibrarian) from official TI ...footprint created using Footprin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
2025-10-06 added Al-Poly_Polarised_Chip_SMD_6V3_220uF_L7.3xW4.3xH1.9mm_Panasonic_CX...symbol copied from existing & adapted, footprint custom ...datasheet from panasonic official ...3D model from SamacSys (link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
2025-10-08 added TagConnect_6pin_UART_NoLegs copied existing symbol & adapted, uses existing footprint
2025-10-10 added Buffer_Dual_Schmitt_1V65-5V5_Texas-Instruments_SN74LVC2G17_SC-70-6 ... ...copied existing non-schmitt buffer SN74LVC2G34 ...datasheet from official TI ...re-use existing footprint (checked, OK 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
2025-10-10 added NOR-2_Dual_1V65-5V5_Nexperia_74LVC2G02_SOT833-1 ... ...datasheet & 3D model from Nexperia official ...symbol copied existing & adapted ...footprint made custom based on datasheet
2025-10-13 added Latch_D-type_Octal_1V2-3V6_Nexperia_74LVC573A_SOT764-1... ...symbol made custom from datasheet ...footprint from Footprint expert and adapted ...datasheet & 3D model from Nexperia official
2025-10-16 add smaller version of VSMSC logo in silkscreen mirrored & rotated existing VSMSC footprints & this new one
2025-10-17 removed silkscreen refdes from fiducial marker footprints
2025-10-17 update vSMSC soldermask logo mark to new branding
2025-10-17 added Ferrite_SMD_2012_4A_30R_Murata_BLM21PG300SN1D ... ...copied existing symbol & adapted info ...datasheet from murata official ...footprint from kicad official
2025-10-17 TVS_Unidir_Dual_HighSpeedData_ST-Micro_USBLC6-2_SOT-666 shortened pins, removed pin names
2025-10-28 change all existing DNF parts to 'exclude from BOM' (no genuine physical BOM parts were marked this way in library)
2025-10-28 remove "FitPart" field / part attribute from all library parts (to change to use KiCAD built-in DNP field) add script to script folder
2025-10-28 update scripts etc for KiCAD DNF/DNP change update for InteractiveHtmlBom v2.10.1 delete KiBOM config file (migrated to use KICAD BOM export)
2025-10-29 add kicad CLI render export to script test script with v9
2025-11-03 added LDO_Adjustable_3A_Microchip_MIC29302AWD_TO-252-5... ...symbol created custom, similar to KiCAD official ...footprint from footprint expert & tweaked ...3D model ultralibrarian (microchip offici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
2025-11-03 remove titleblocks from Gerber exports create more trouble than benefit
2025-12-18 remove titleblocks from Gerber exports again (accidentally added back in previous commit)
2025-12-19 add workaround KICAD CLI not overwriting ODB++ export
2026-01-21 revise symbol pin placement for ChargerPowerPath_LithiumLeadAcid_55V_BuckBoost_AnalogDevices_LTC4020I_QFN-38-1EP
2026-02-02 add Inductor_SMD_165155_4.6-33uH_30-13A_WireWound_Shielded_Pulse_PA2247_PM2247... ...datasheet from Yageo official ...3D model from Samacsys (linked from Yageo official) ...footprint, symbol custom
2026-02-02 add PMOS_Single_30V_94A_PowerPAK1212-8S_Vishay_SiSS65DN... ...datasheet from Vishay official ...3D STEP model from Samacsys (no official link) ...symbol custom, with same pinout ...footprint custom, 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
2026-02-04 add NMOS_Single_60V_103A_DFN3333-8_OnSemi_NTTFS3D7N06HL... ...footprint use PowerPAK_1212-8S_Vishay, same dimensions ...datasheet from official OnSemi
2026-02-10 added symbol NetTie_2_Via added footprint NetTie_2_Via_0.2_0.6mm_Track_0.25mm allows via net tie e.g. for current sense resistor Pin1 Top pad, Pin2 Bottom pad with 0.25mm track stub
2026-02-10 added footprint NetTie-2_SMD_Pad0.25mm
2026-02-11 corrected NetTie_2 naming for consistency set net tie RefDes to not visible (same as kicad library)
2026-02-11 correct export script error for KiCAD v9 ... ...new optional VAR for --sort-asc was messing INPUT_FILE
2026-02-11 remove virtual components from HTML BOM plugin output
2026-02-13 added Flip-Flop_D-type_Octal_1V2-3V6_Nexperia_74LVC574A_SOT764-1 ... ...same footprint etc as 74LVC573A, changed Pin11 name CP ...datasheet from Nexperia official minor mods to latch part 74LVC573A
2026-02-17 adding ERC/DRC to kicad python design pack export script... ...has issues with which it reports and return code
2026-02-18 script changes for v10 script changes for BOM & PDF variant feature not yet added PCB position file for variants not yet resolved difference in Font vs. v9
2026-03-02 added NMOS_Single_30V_54A_DFN3333-8_Texas-Instruments_CSD17578Q3A ... ...datasheet from TI official website ...symbol custom, partially copied ...footprint re-use existing
2026-03-05 updated vSMSC soldermask logo to new type
2026-04-30 updated vSMSC mask & silk logos to new type made silkscreen one the same size rotated so oriented as viewed in fp editor
2026-05-06 updated kicad export script for 'pypdf' v6.x
2026-05-11 export script, pcb render --use-board-stackup-colors
2026-10-01 added SOD-923_Bidir.kicad_mod... ...bidirectional version, but without cathode mark ...footprint from existing SOD-923 but made bidirectional fab+silk ...add 3D model from kicad, copied and AI made w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
2026-10-07 updated symbol libraries for KiCAD v10.0.6 using; kicad-cli sym upgrade --force INPUT_FILE
2026-10-07 updated footprint libraries for KiCAD v10.0.6 using; kicad-cli fp upgrade --force INPUT_FILE
2026-10-07 updated worksheet & readme for KiCAD v10.0.6
2026-10-07 update KiCAD v10 footprint 3D model paths
2026-10-07 add PCB statistics report to export script change DRC and ERC report to same folder/format change DRC and ERC to not include exlusions
2026-10-07 updated symbol missed before (master branch) to KiCAD v10.0.6 kicad-cli sym upgrade --force INPUT_FILE
2026-10-07 update PCB export script for KiCAD v10; - IPC2581 export now .zip file extension - add IPC2581 BOM REV (fixed in v10) - remove IPC2581 DIST fields (single fixed DIST, not useful) - set render zoom to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
2026-10-07 PCB export script - render zoom level 1.2 (was 1.0) other minor text comments changes
2026-10-08 PCB Export script now use --mode-multipage flag issues fixed in v10, even 50% smaller now, fixes page numbering!
2026-10-12 remove '--disable-aperture-macros' from gerber export... ...now most common recommended way (e.g. KiCAD, JLCPCB, Claude all do) ...may fix issues JLC turning rounded rectangle pads into rectangles
2026-10-12 add pcb_export_drill_pdf() to export script... ...merged single page PDFs so uses pypdf again
2026-10-15 add footprint 'points' at useful places delete legacy PCB_Silk_Logo_KB silk logo footprint
2026-10-15 stacked display of symbol pin numbers where useful... ...essentially only with multiple adjacent pins of same net
2026-10-15 Fix filename case of CFPX-217 & AG6120 models to match footprints
2026-10-16 add ethernet magnetics SM13126PEL keepout layer 4mm min
2026-10-16 added local power and ground symbols copied from official libraries and adapted power_VDD_local power_GND_local
